asherflynt/voice-clock/docs/renders.md

# Renders

All images are rendered in Blender (Cycles) from the parametric CAD in `cad/` and the same paint data the slicer gets. Wood tones are shown as their filament or blended colour, so real prints will differ slightly.

## Turned walnut, Full Spectrum (8 tones)

Print files: [`print/wood_walnut`](../print/wood_walnut/README.md)

| | |
|---|---|
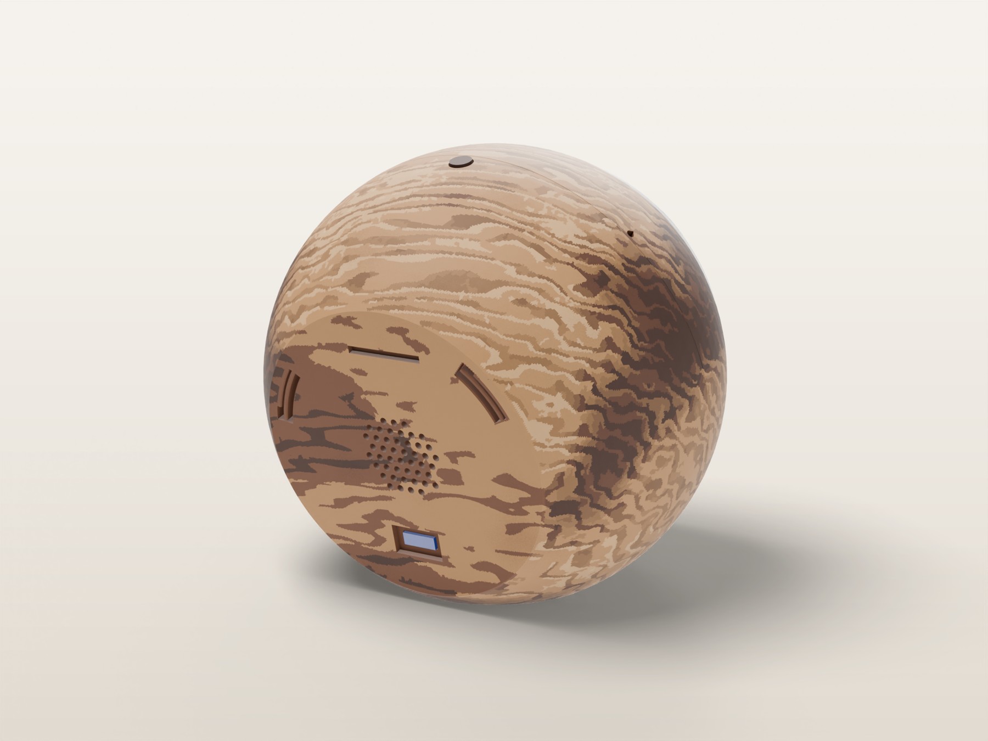
[picture p6: docs/img/wood/walnut_back.jpg]
back
| front |  |
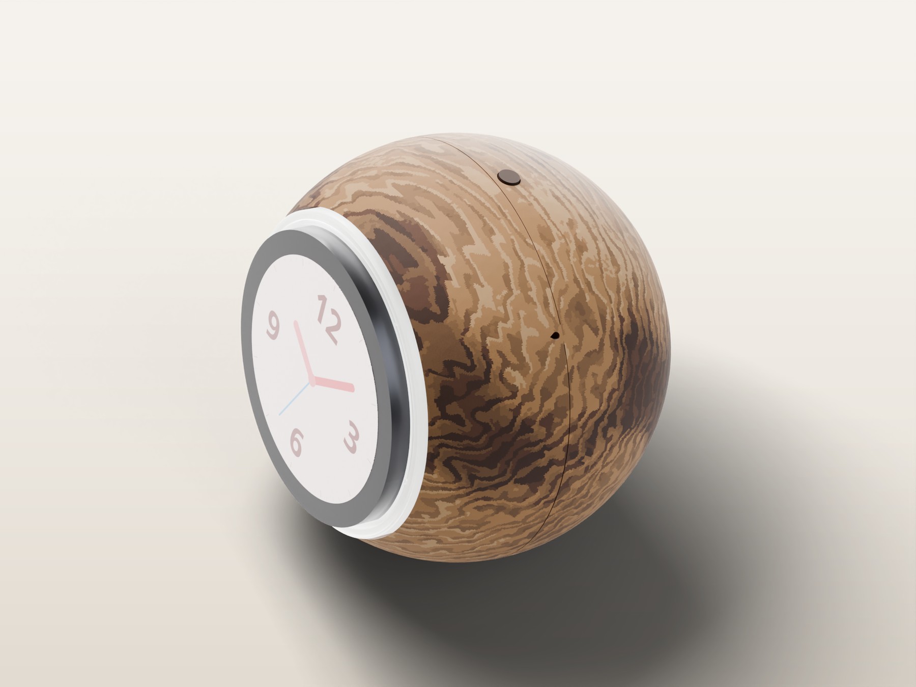
[picture p7: docs/img/wood/walnut_top.jpg]
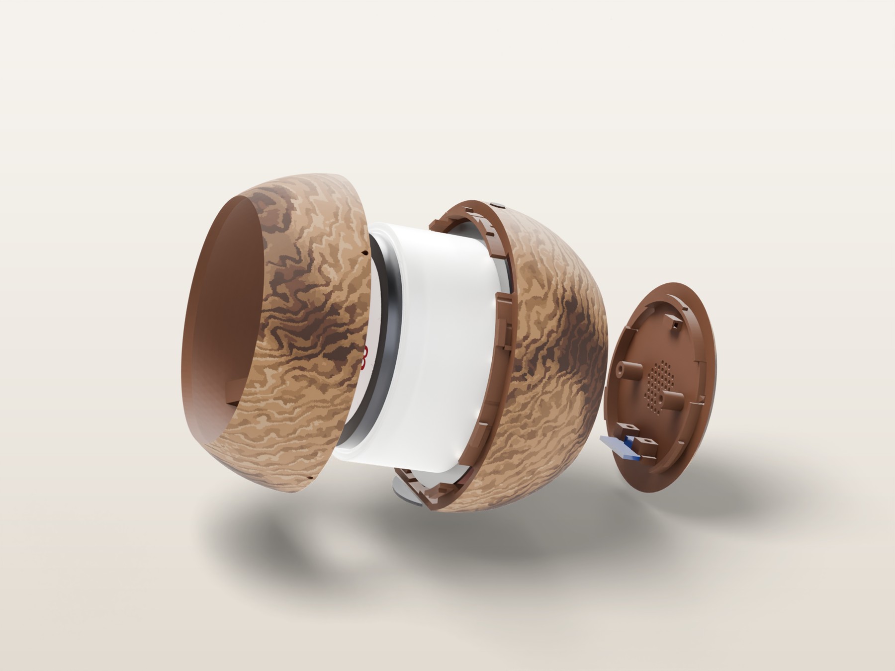
[picture p8: docs/img/wood/walnut_parts.jpg]
|  |  |

## Turned cherry

Print files: [`print/wood`](../print/wood/README.md)

| | |
|---|---|
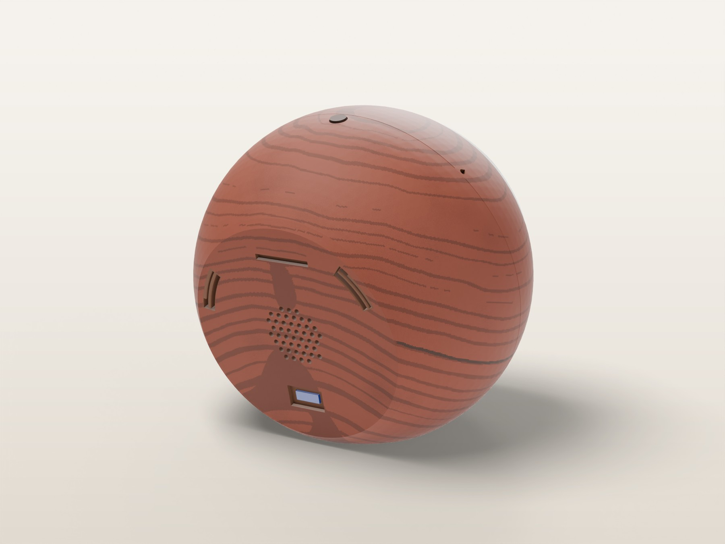
[picture p9: docs/img/wood/wood_back.jpg]
back
| front |  |
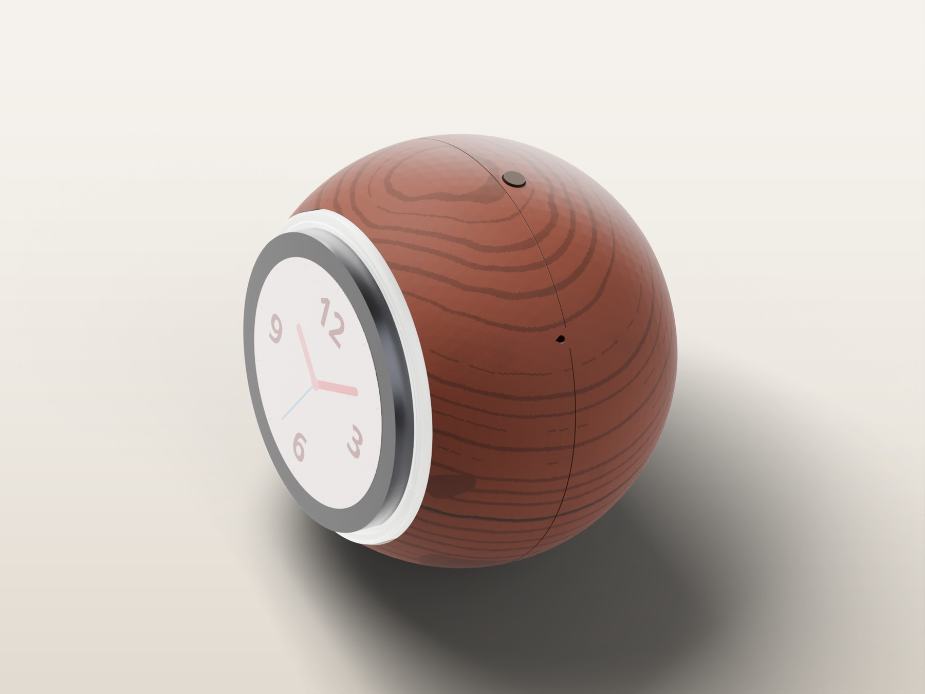
[picture p10: docs/img/wood/wood_top.jpg]
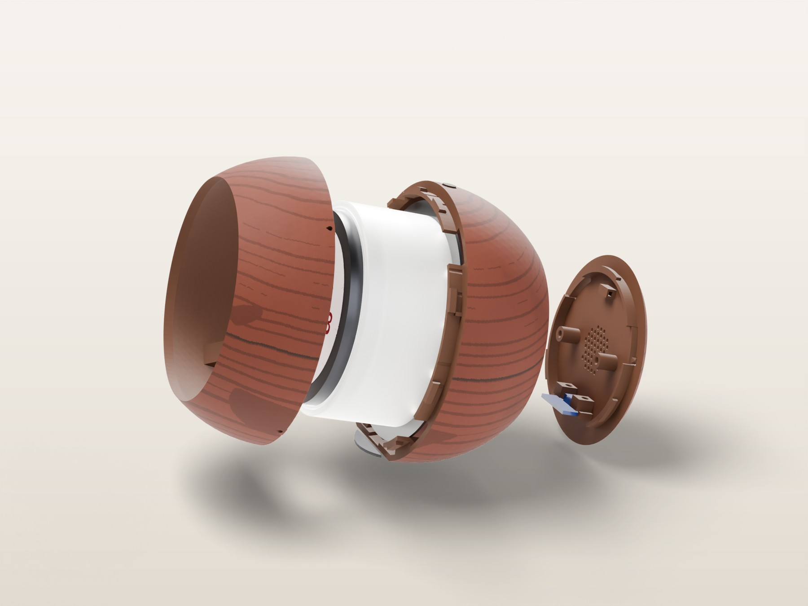
[picture p11: docs/img/wood/wood_parts.jpg]
|  |  |

## Standard build and assembly steps

In order, as used in the [assembly guide](assembly/ASSEMBLY.md).

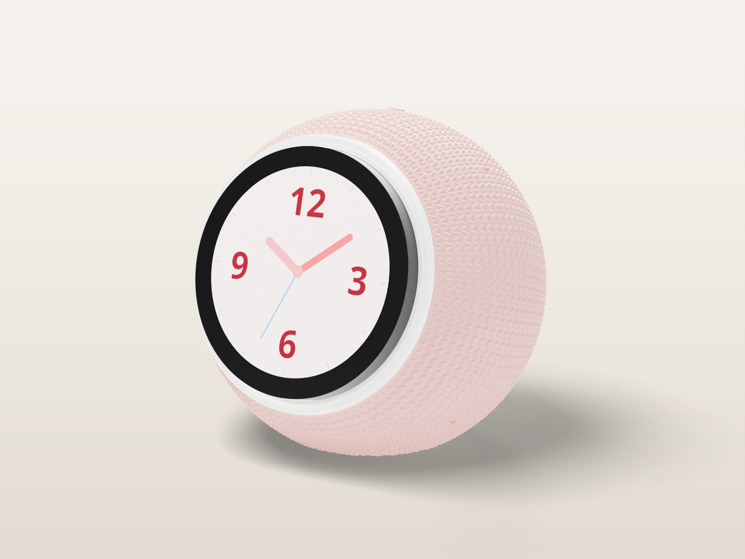
[picture p12: docs/assembly/img/hero_front.jpg]
hero_front


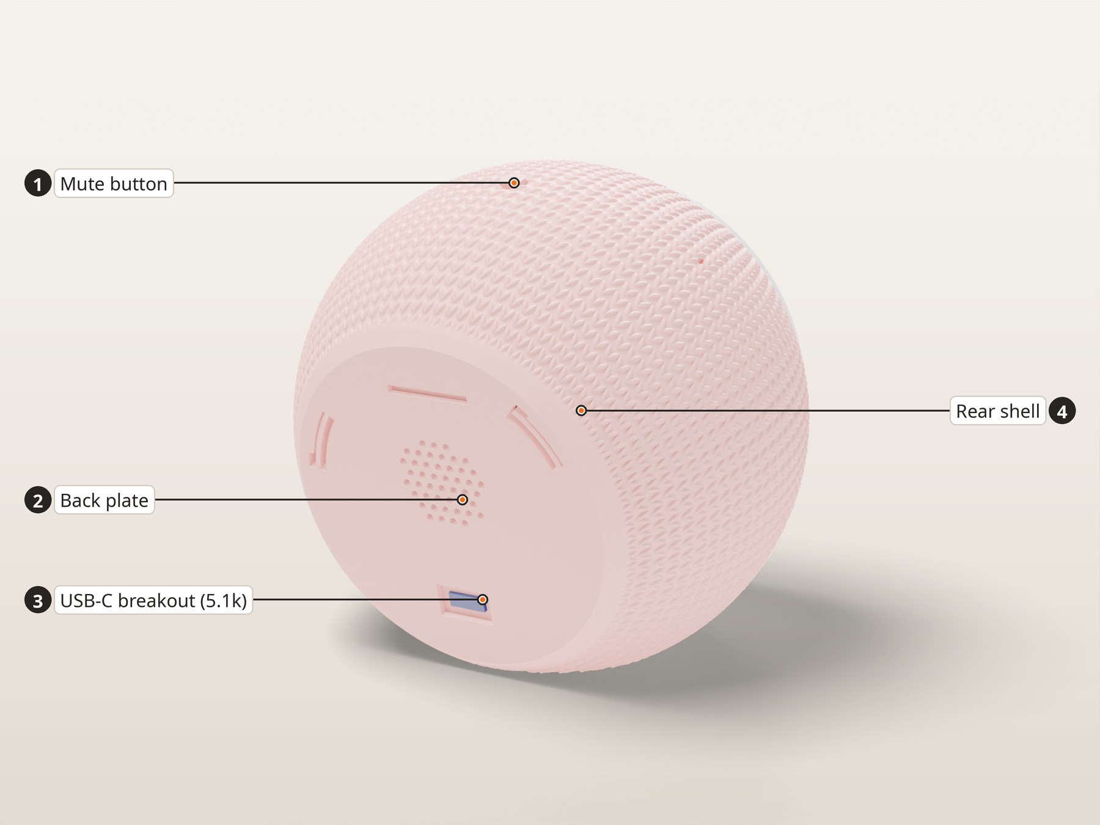
[picture p13: docs/assembly/img/hero_back.jpg]
hero_back


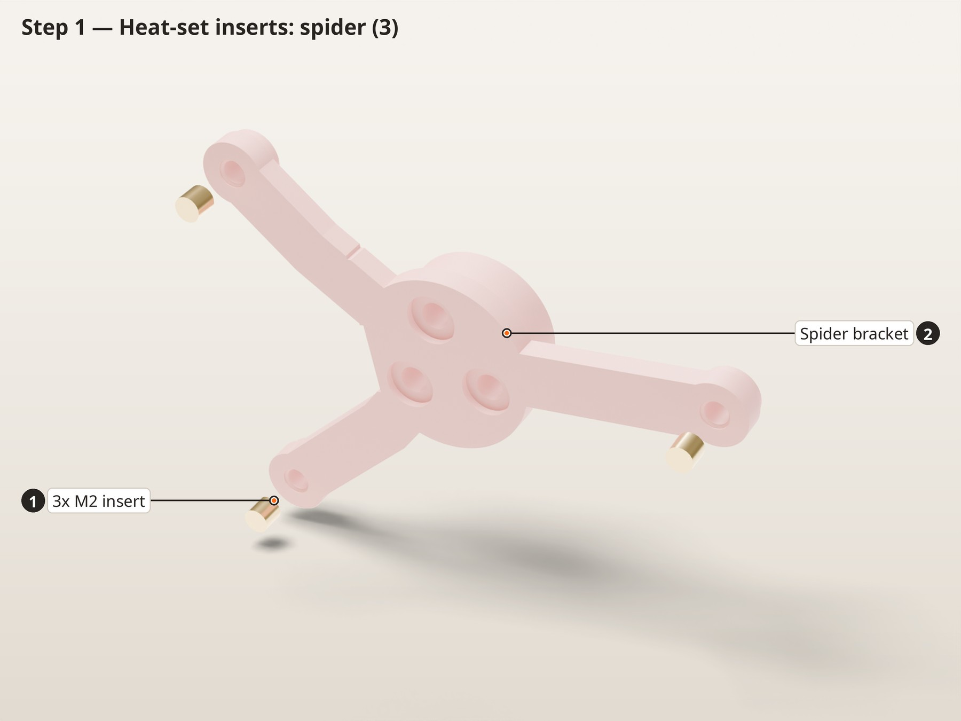
[picture p14: docs/assembly/img/step_01.jpg]
step_01


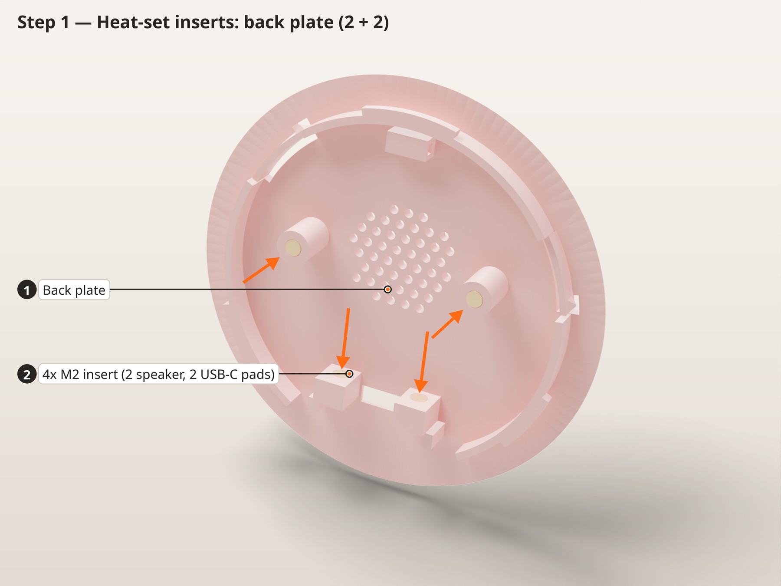
[picture p15: docs/assembly/img/step_01b.jpg]
step_01b


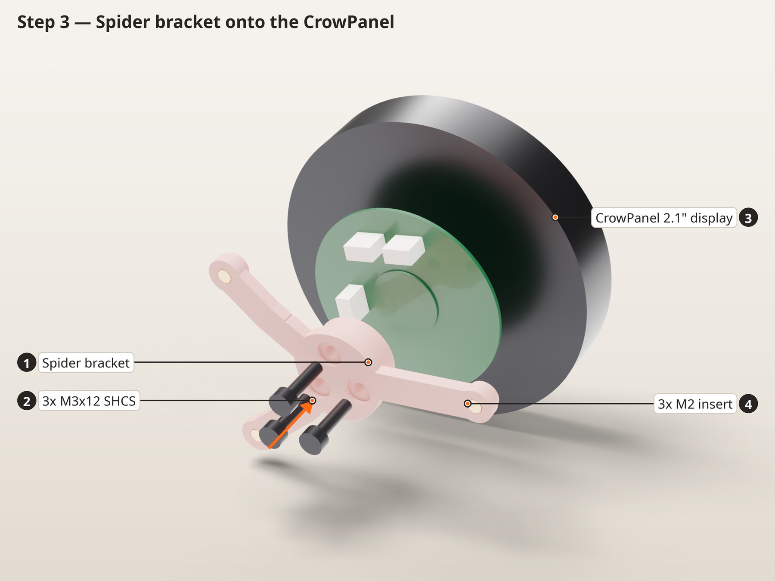
[picture p16: docs/assembly/img/step_02.jpg]
step_02


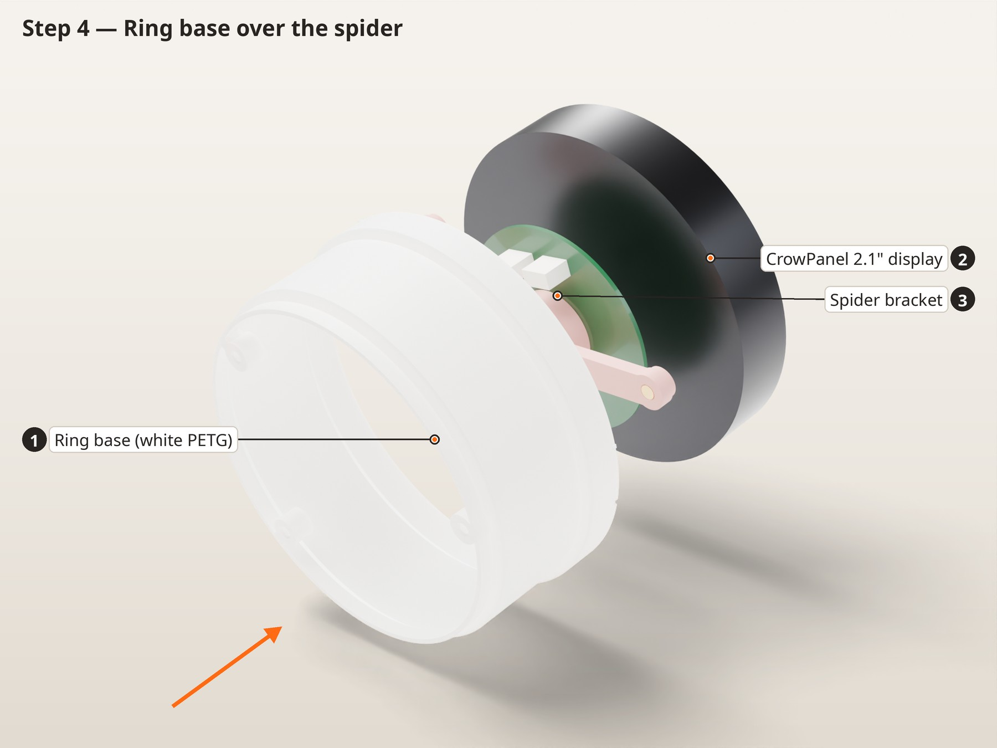
[picture p17: docs/assembly/img/step_03.jpg]
step_03


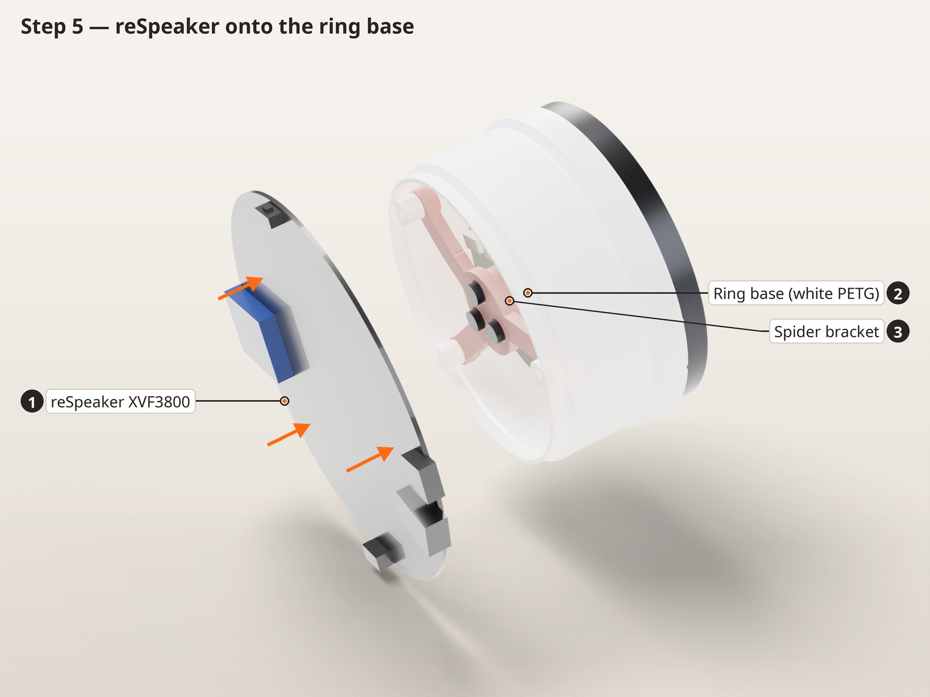
[picture p18: docs/assembly/img/step_04.jpg]
step_04


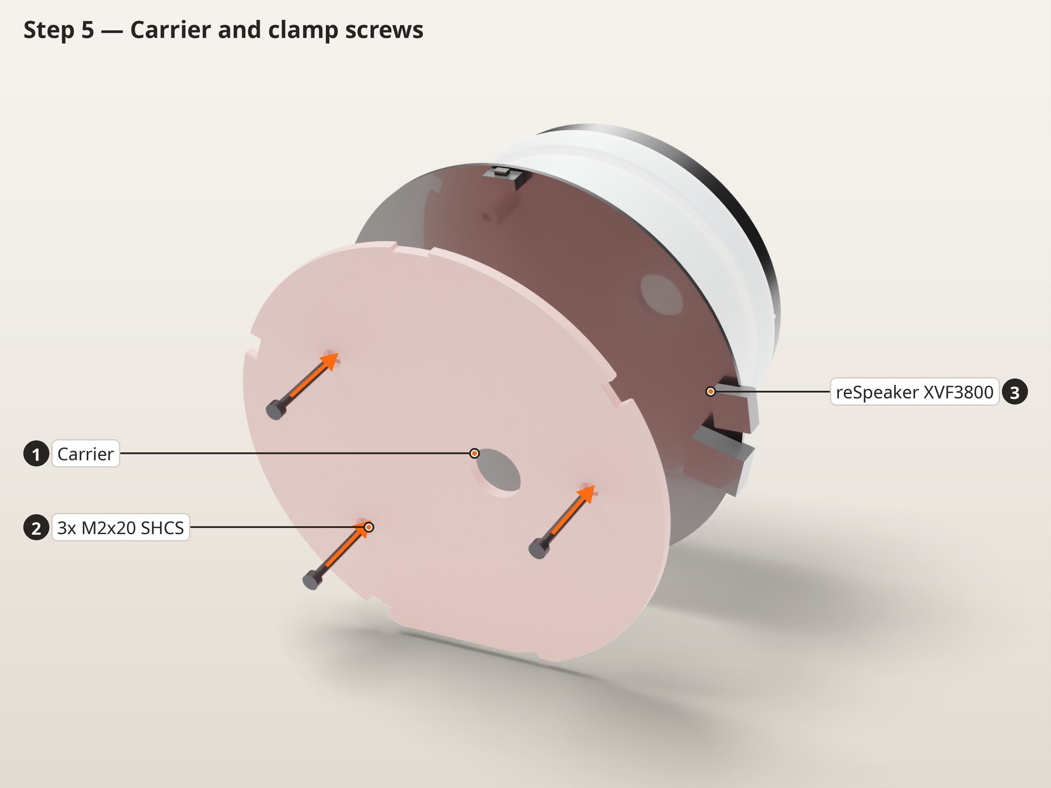
[picture p19: docs/assembly/img/step_05.jpg]
step_05


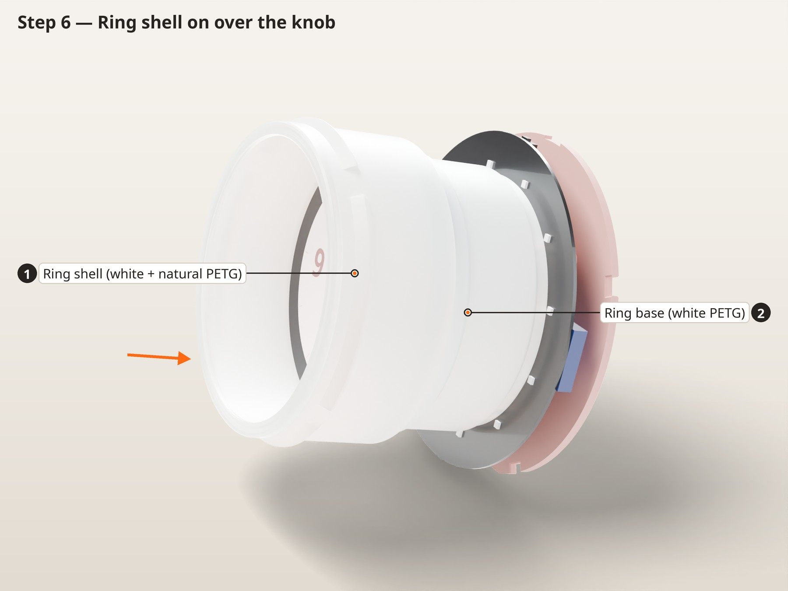
[picture p20: docs/assembly/img/step_06.jpg]
step_06


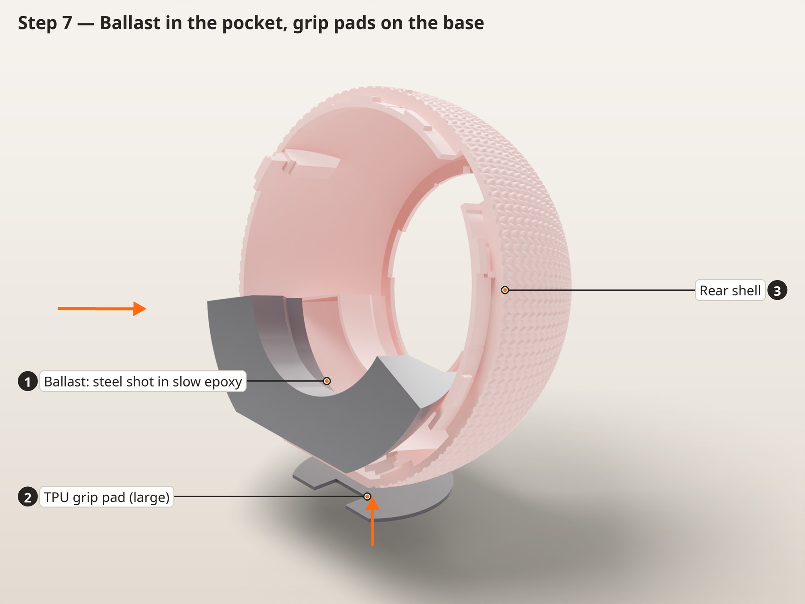
[picture p21: docs/assembly/img/step_07.jpg]
step_07


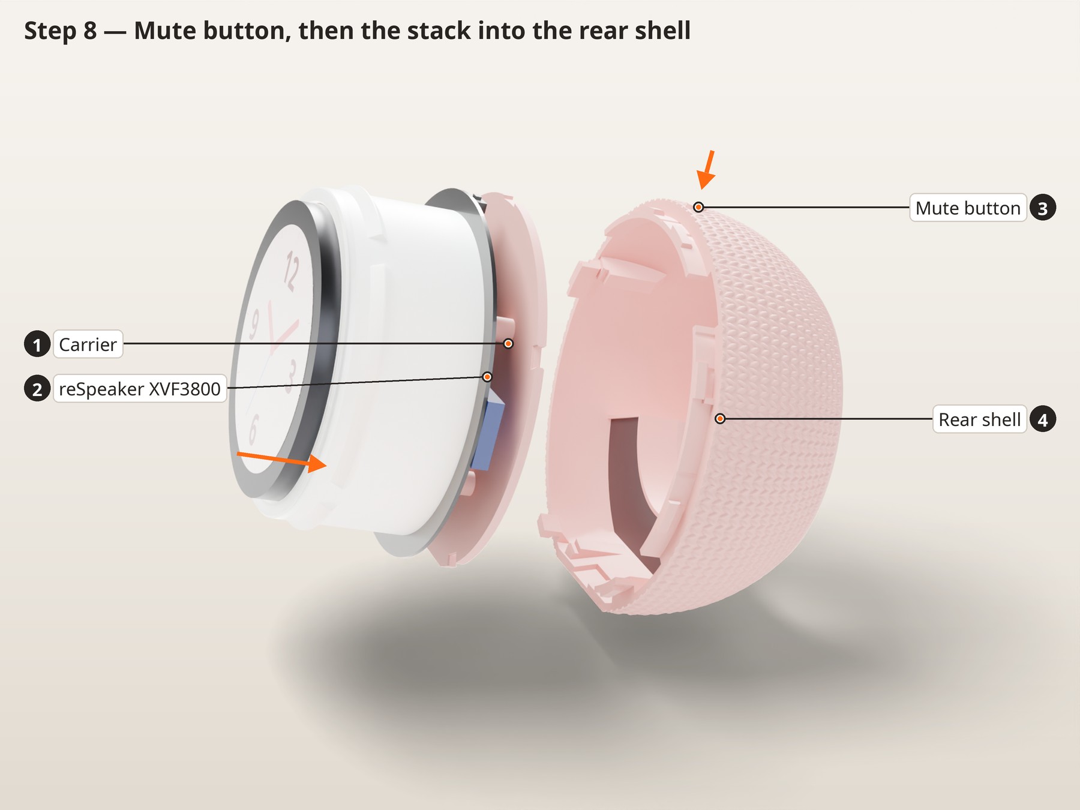
[picture p22: docs/assembly/img/step_08.jpg]
step_08


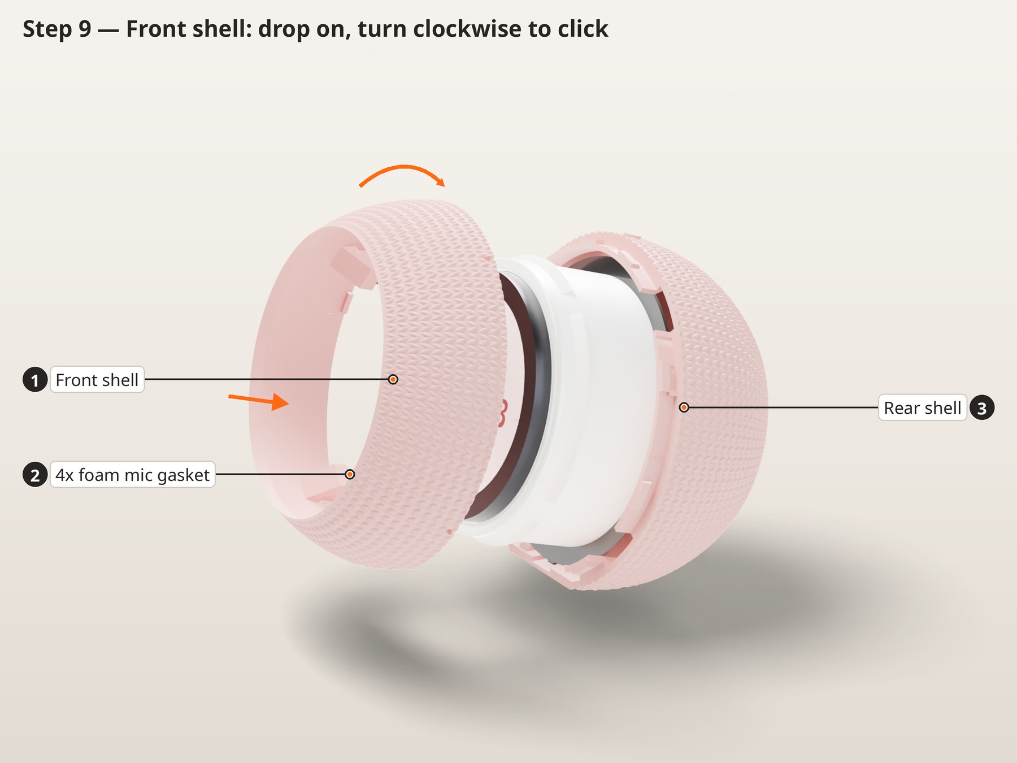
[picture p23: docs/assembly/img/step_09.jpg]
step_09


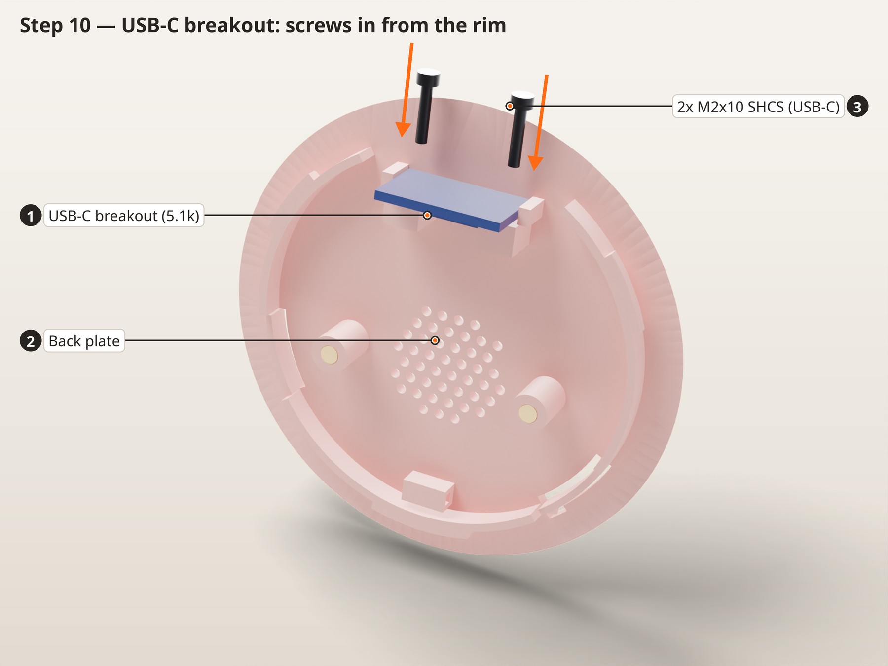
[picture p24: docs/assembly/img/step_10.jpg]
step_10


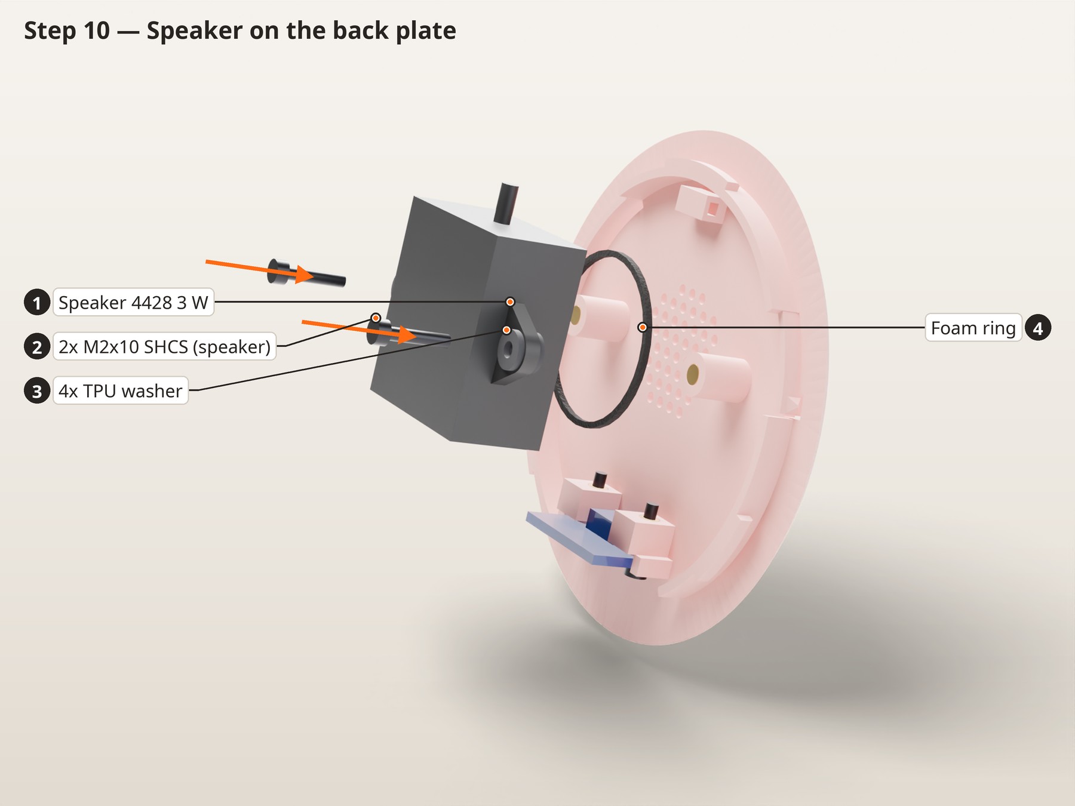
[picture p25: docs/assembly/img/step_10b.jpg]
step_10b


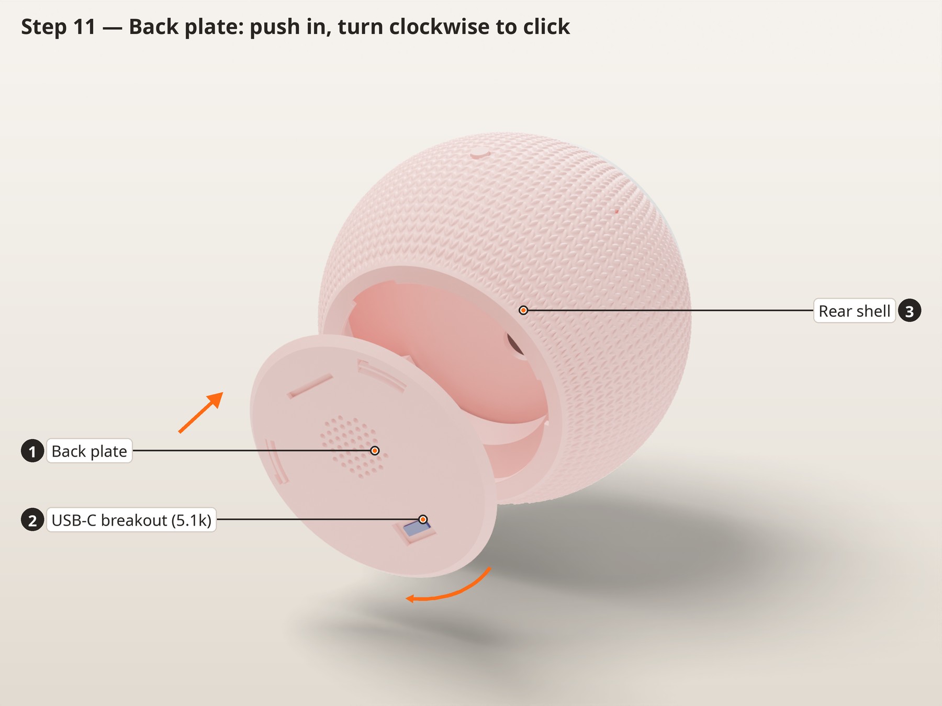
[picture p26: docs/assembly/img/step_11.jpg]
step_11


## Side section

Side section
