asherflynt/voice-clock/cad/blender/clockface.png

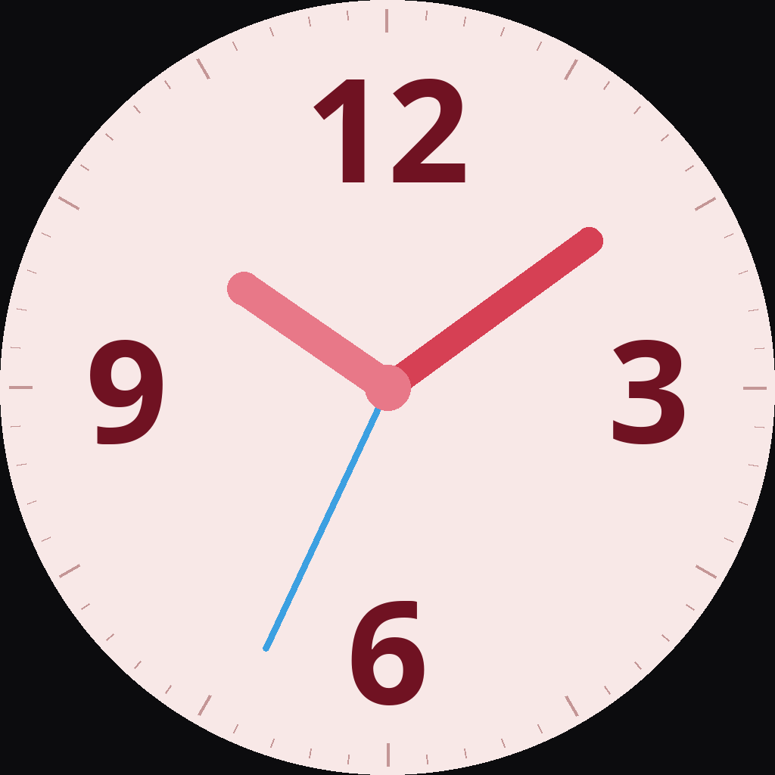
cad/blender/clockface.png
