asherflynt/voice-clock/print/step/assembly_D.step

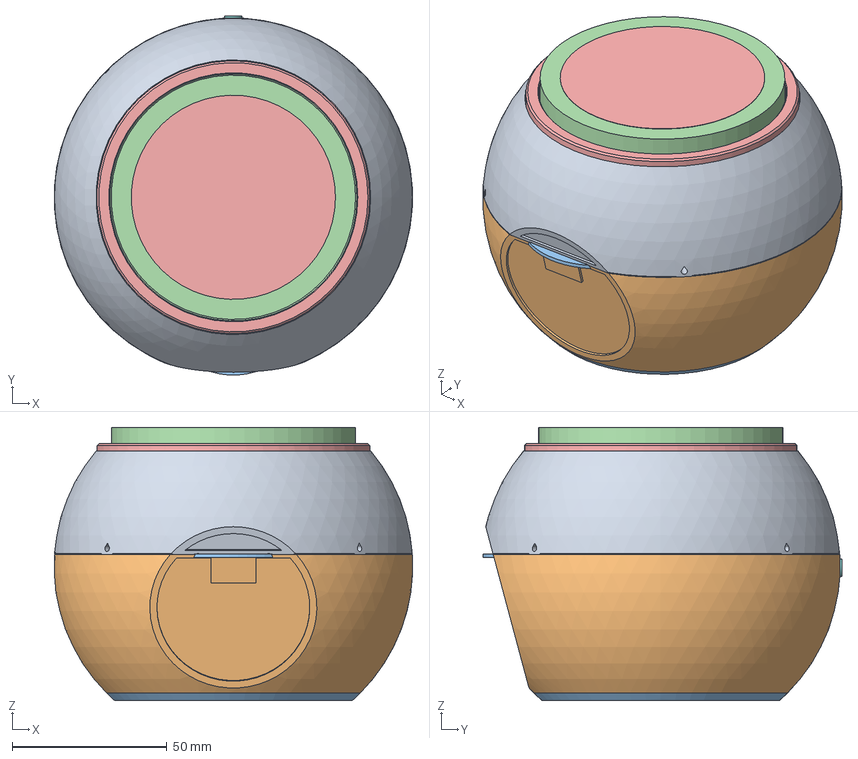
[picture p28: CAD file, 2026-11-12]
print/step/assembly_D.step
115.8 x 116.1 x 88.3 mm
Open_CASCADE_STEP_translator_7_9_1
