asherflynt/voice-clock/print/bambu/VoiceClock_P1S.3mf

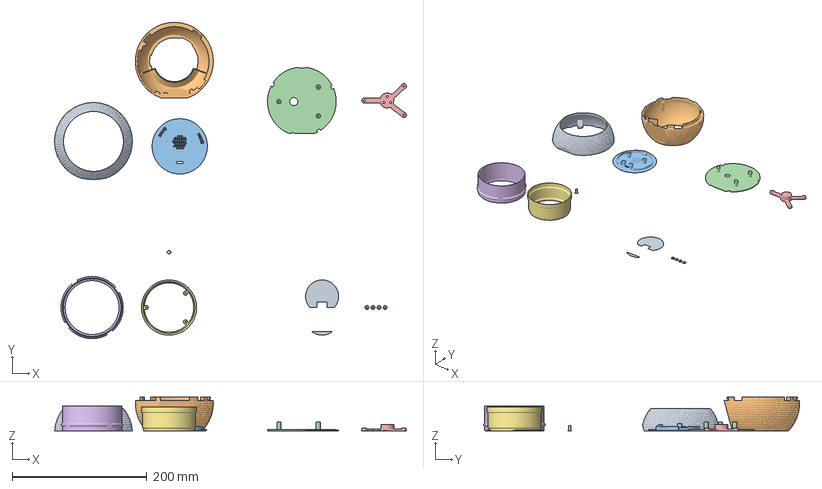
[picture p29: CAD file, 2026-11-12]
print/bambu/VoiceClock_P1S.3mf
522.3 x 469.5 x 50.4 mm
front_shell
rear_shell
back_plate
carrier
spider
ring_shell_2c
ring_base
mute_plunger
foot_pads
tpu_washers
