asherflynt/voice-clock/print/fit_tests/VoiceClock_v2_fit_plate2.3mf

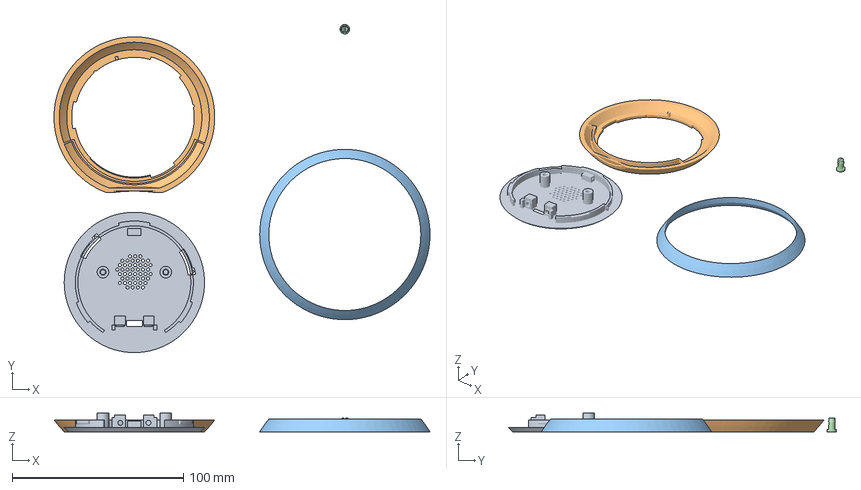
[picture p30: CAD file, 2026-11-10]
print/fit_tests/VoiceClock_v2_fit_plate2.3mf
219.7 x 191.8 x 10.9 mm
back_plate
fit_back_ring
fit_front_top
mute_plunger
