asherflynt/voice-clock/print/light_ring/LightRing_PETG_U1.3mf

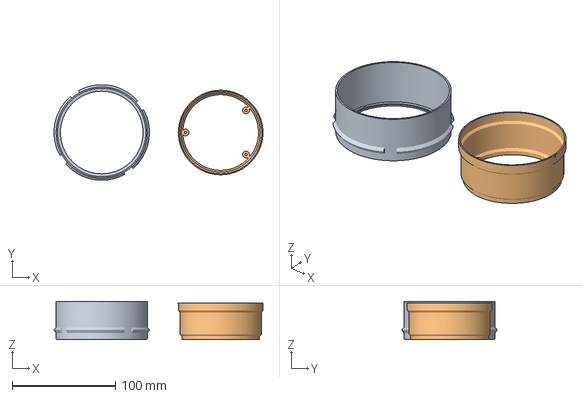
[picture p31: CAD file, 2026-11-11]
print/light_ring/LightRing_PETG_U1.3mf
202.3 x 92.4 x 36.9 mm
ring_shell_2c
ring_base
