asherflynt/voice-clock/print/plates/VoiceClock_plate1.3mf

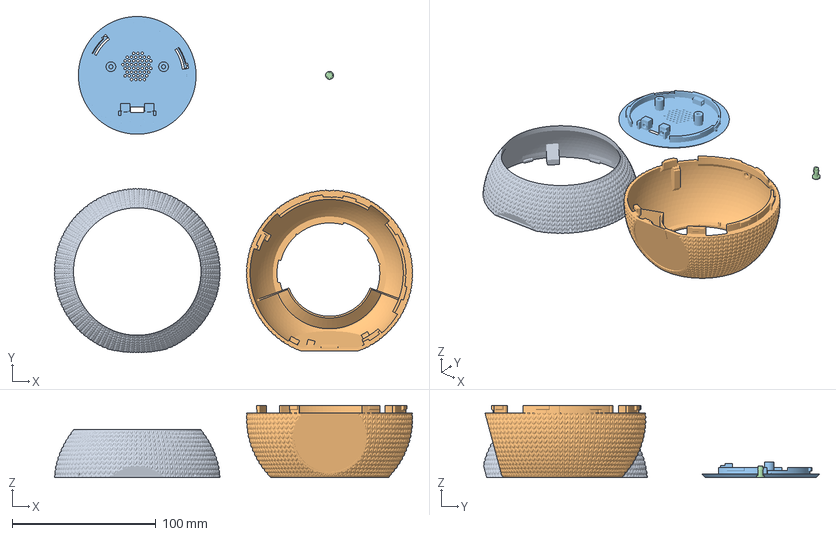
[picture p32: CAD file, 2026-11-12]
print/plates/VoiceClock_plate1.3mf
249.8 x 234.1 x 50.4 mm
front_shell
rear_shell
back_plate
mute_plunger
