asherflynt/voice-clock/print/step/spider.step

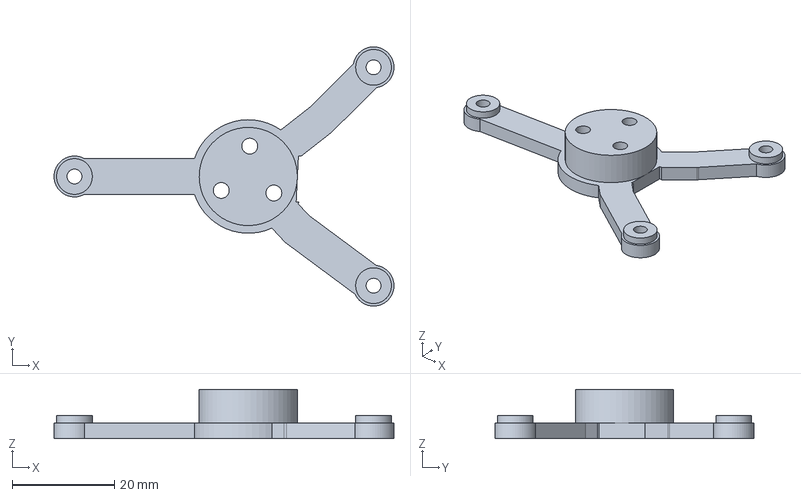
[picture p33: CAD file, 2026-11-12]
print/step/spider.step
66.5 x 50.7 x 9.60 mm
