asherflynt/voice-clock/print/stl/ring_shell_natural.stl

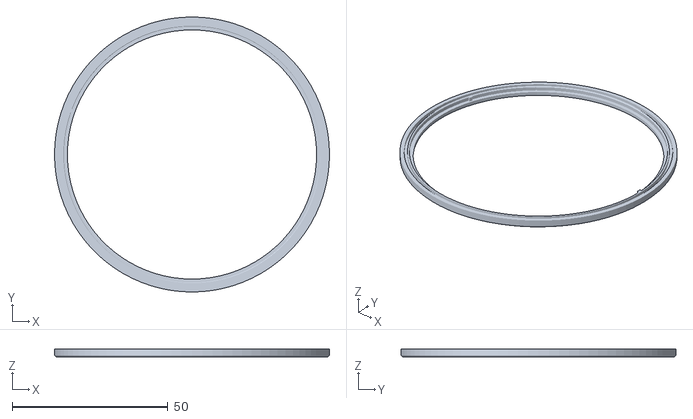
[picture p34: CAD file, 2026-11-11]
print/stl/ring_shell_natural.stl
88.2 x 88.2 x 2.65
