asherflynt/voice-clock/print/tpu/TPU_U1.3mf

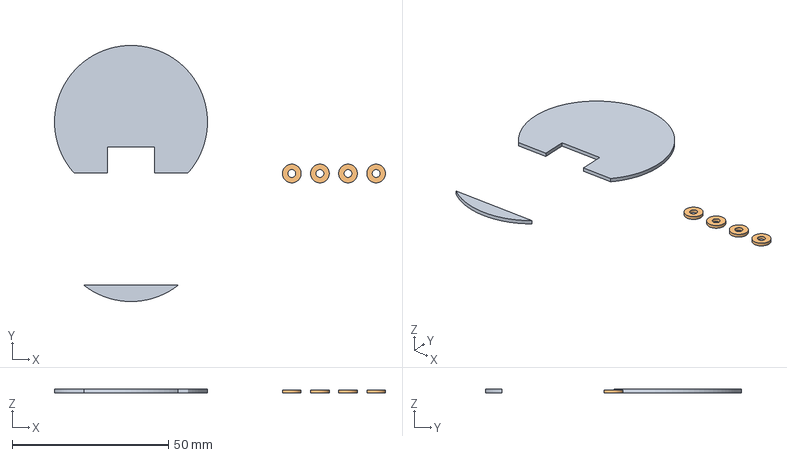
[picture p35: CAD file, 2026-11-12]
print/tpu/TPU_U1.3mf
106.0 x 82.0 x 1.20 mm
foot_pads
tpu_washers
