asherflynt/voice-clock/print/v3_light_sensor/VoiceClock_walnut_fs_008_U1_light_sensor.3mf

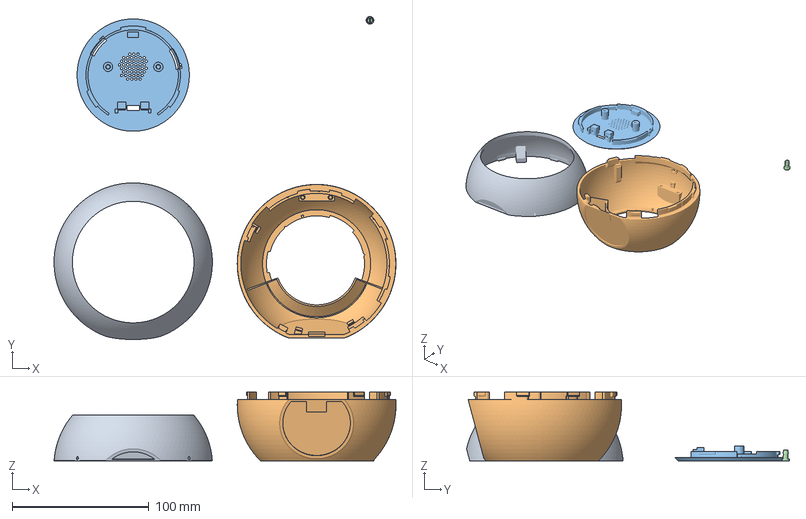
[picture p36: CAD file, 2026-11-13]
print/v3_light_sensor/VoiceClock_walnut_fs_008_U1_light_sensor.3mf
249.8 x 236.0 x 50.4 mm
front_shell
rear_shell
back_plate
mute_plunger
