asherflynt/voice-clock/print/VoiceClock_U1.3mf

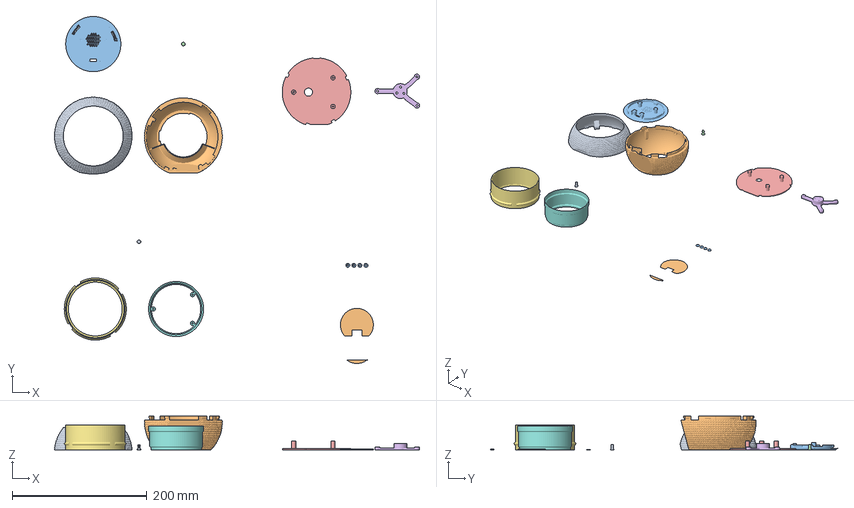
[picture p37: CAD file, 2026-11-12]
print/VoiceClock_U1.3mf
543.1 x 516.0 x 50.4 mm
front_shell
rear_shell
back_plate
mute_plunger x 2
carrier
spider
ring_shell_2c
ring_base
foot_pads
tpu_washers
