asherflynt/voice-clock/print/wood/coupons/C1_JAYO_Wood_Cherry_U1.3mf

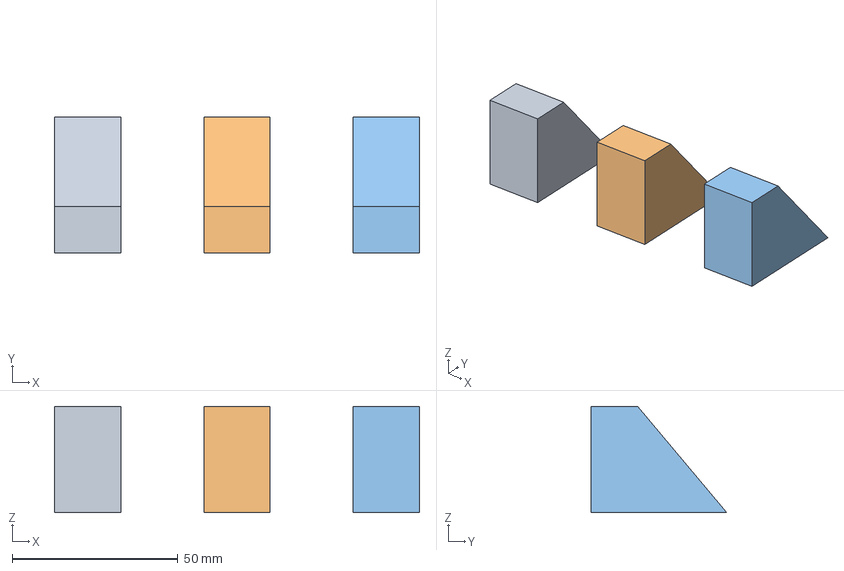
[picture p38: CAD file, 2026-11-07]
print/wood/coupons/C1_JAYO_Wood_Cherry_U1.3mf
110.0 x 40.9 x 32.0 mm
c1_2p5
c1_4
c1_8
