asherflynt/voice-clock/print/wood/VoiceClock_wood_U1.3mf

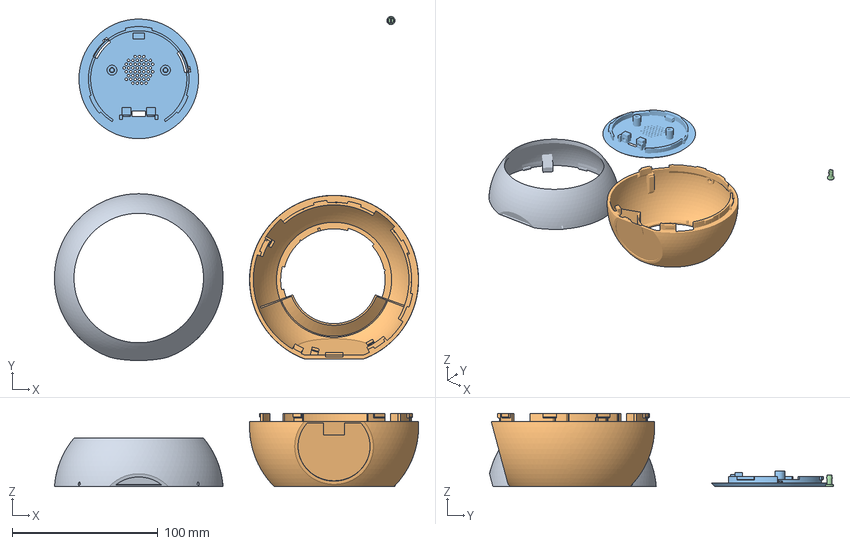
[picture p39: CAD file, 2026-11-10]
print/wood/VoiceClock_wood_U1.3mf
249.8 x 236.0 x 50.4 mm
front_shell
rear_shell
back_plate
mute_plunger
