asherflynt/voice-clock/print/wood_walnut/coupons/FS_swatch_008.3mf

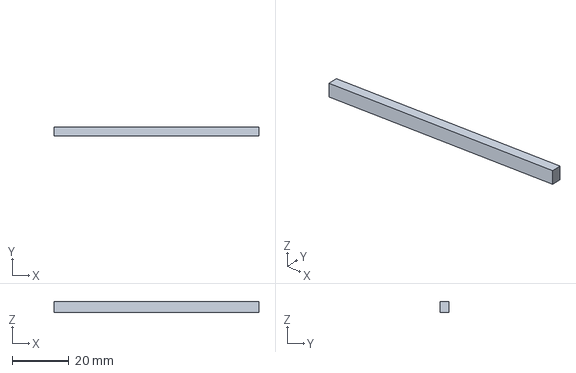
[picture p40: CAD file, 2026-11-07]
print/wood_walnut/coupons/FS_swatch_008.3mf
72.0 x 3.00 x 4.00 mm
