asherflynt/voice-clock/print/bambu/VoiceClock_A1mini.3mf

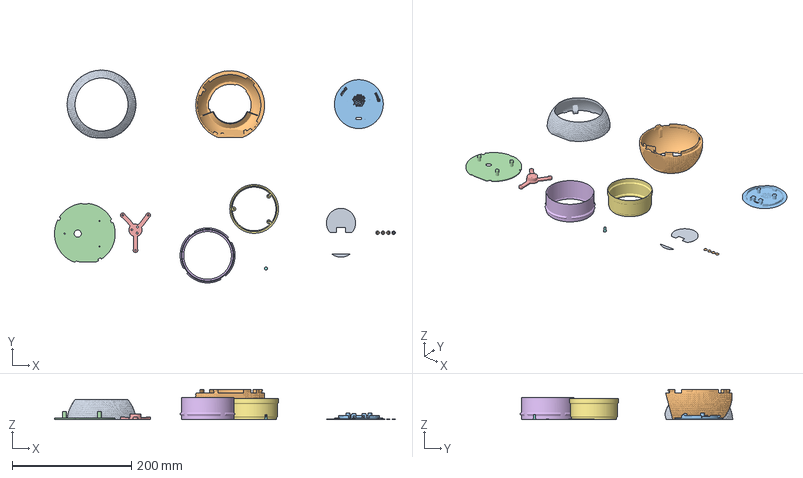
[picture p41: CAD file, 2026-11-12]
print/bambu/VoiceClock_A1mini.3mf
572.5 x 357.3 x 50.4 mm
front_shell
rear_shell
back_plate
carrier
spider
ring_shell_2c
ring_base
mute_plunger
foot_pads
tpu_washers
