asherflynt/voice-clock/print/fit_tests/VoiceClock_v2_fit_tests.3mf

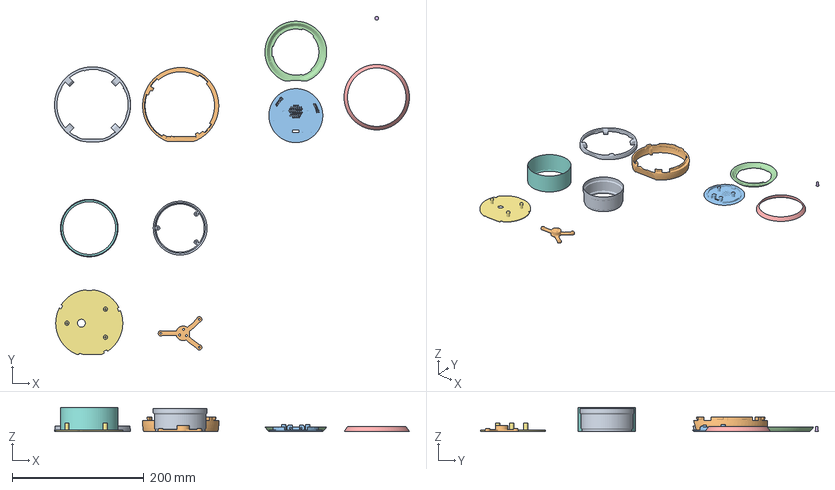
[picture p42: CAD file, 2026-11-10]
print/fit_tests/VoiceClock_v2_fit_tests.3mf
539.6 x 514.1 x 36.9 mm
fit_front_band
fit_rear_band
back_plate
fit_back_ring
fit_front_top
mute_plunger
carrier
ring_shell
ring_base
spider
