asherflynt/voice-clock/print/light_ring/LightRingShell_PETG_model.3mf

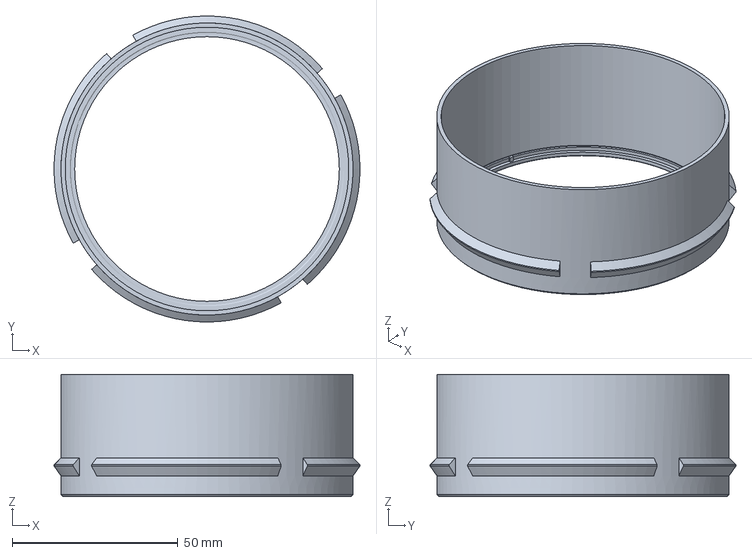
[picture p43: CAD file, 2026-11-11]
print/light_ring/LightRingShell_PETG_model.3mf
92.4 x 92.4 x 36.9 mm
