asherflynt/voice-clock/print/plates/VoiceClock_light_ring_PETG.3mf

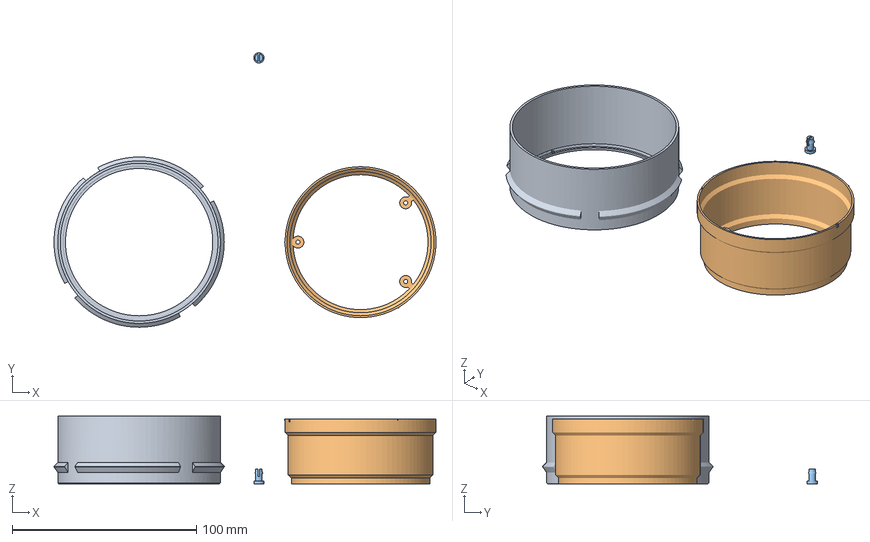
[picture p44: CAD file, 2026-11-12]
print/plates/VoiceClock_light_ring_PETG.3mf
207.3 x 149.0 x 36.9 mm
ring_shell_2c
ring_base
mute_plunger
