asherflynt/voice-clock/print/stl/ring_shell_white.stl

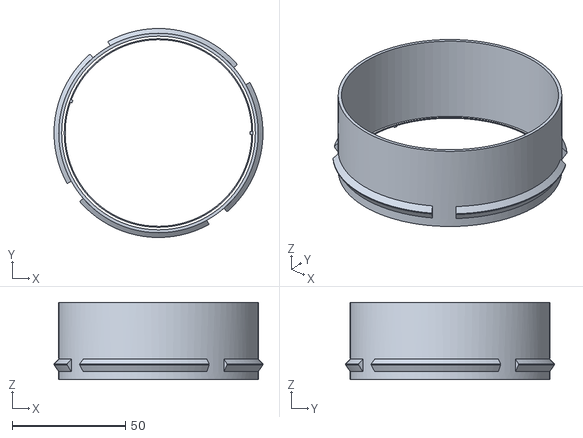
[picture p45: CAD file, 2026-11-11]
print/stl/ring_shell_white.stl
92.4 x 92.4 x 34.2
