asherflynt/voice-clock/print/fit_tests/VoiceClock_v2_fit_plate3.3mf

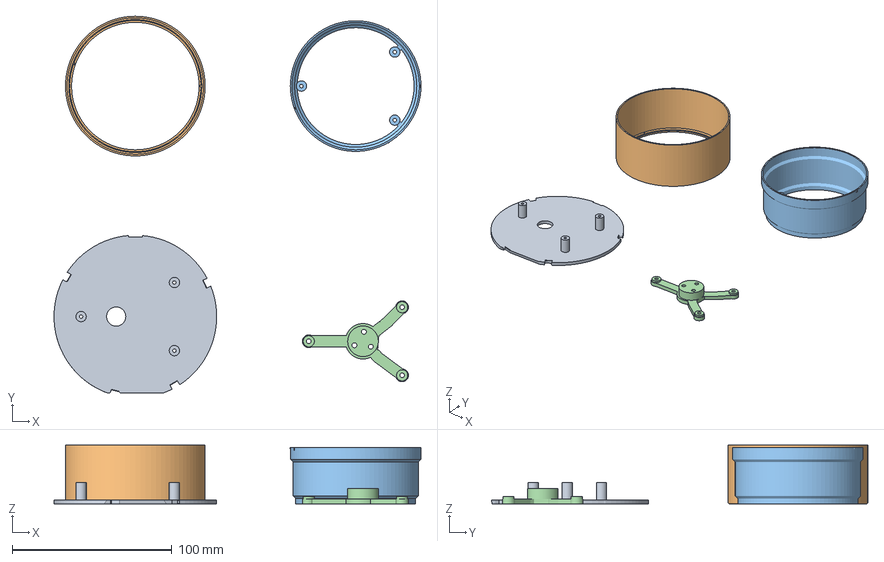
[picture p46: CAD file, 2026-11-10]
print/fit_tests/VoiceClock_v2_fit_plate3.3mf
230.1 x 236.1 x 36.9 mm
carrier
ring_shell
ring_base
spider
