asherflynt/voice-clock/print/plates/VoiceClock_back_plate_only_generic.3mf

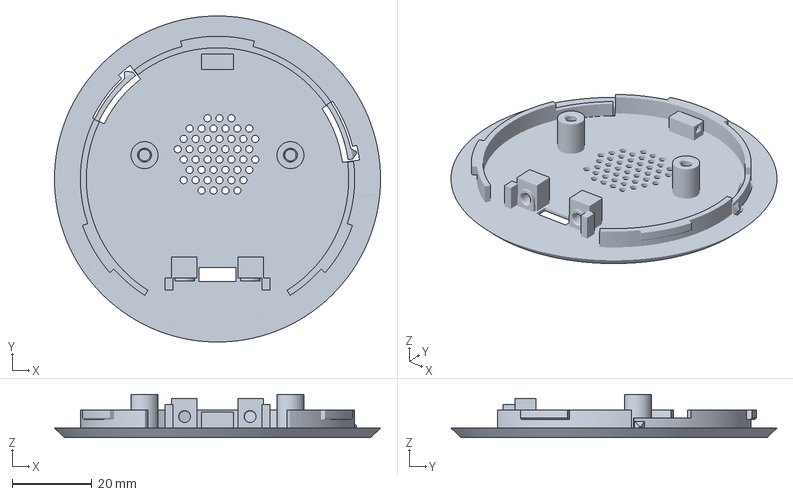
[picture p47: CAD file, 2026-11-12]
print/plates/VoiceClock_back_plate_only_generic.3mf
82.0 x 82.0 x 10.9 mm
