asherflynt/voice-clock/print/step/ring_shell.step

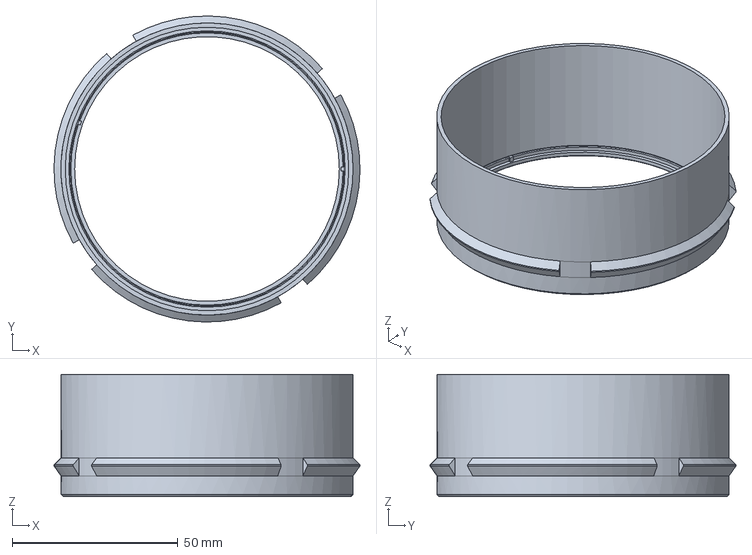
[picture p48: CAD file, 2026-11-11]
print/step/ring_shell.step
92.4 x 92.4 x 36.9 mm
