asherflynt/voice-clock/print/fit_tests/VoiceClock_v2_fit_plate1.3mf

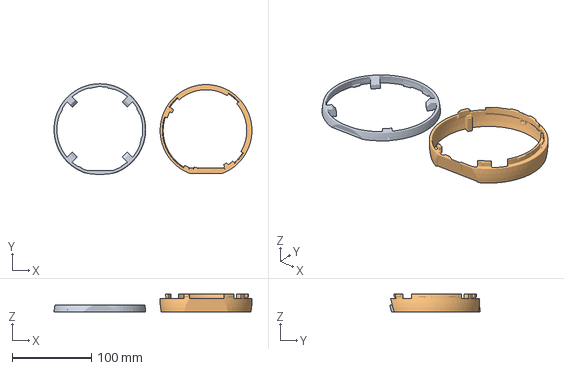
[picture p49: CAD file, 2026-11-09]
print/fit_tests/VoiceClock_v2_fit_plate1.3mf
249.8 x 114.3 x 22.1 mm
fit_front_band
fit_rear_band
