asherflynt/voice-clock/print/v3_light_sensor/carrier_light_sensor.step

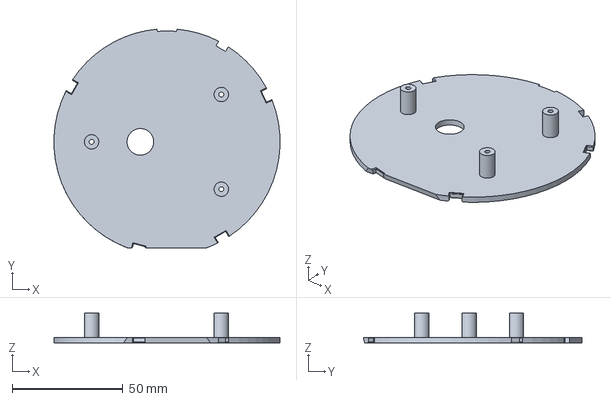
[picture p50: CAD file, 2026-11-13]
print/v3_light_sensor/carrier_light_sensor.step
101.9 x 98.6 x 13.4 mm
