asherflynt/voice-clock/print/plates/VoiceClock_internals_with_back_plate_PLA.3mf

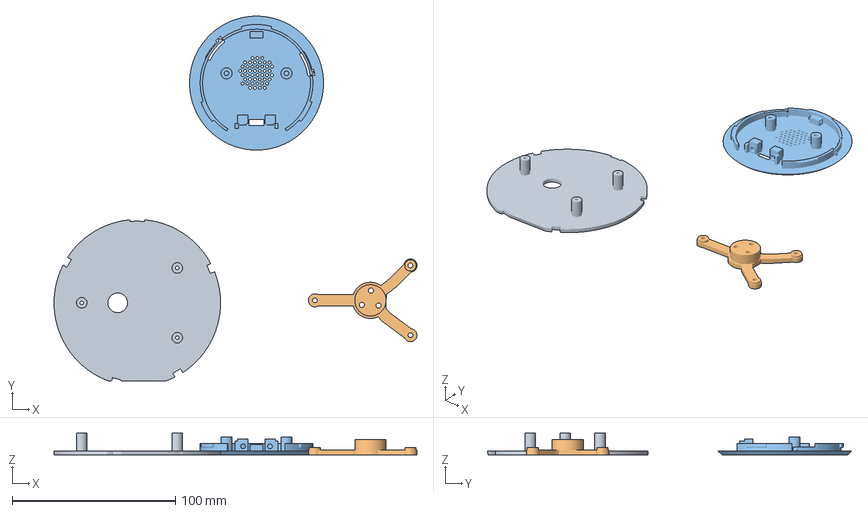
[picture p51: CAD file, 2026-11-12]
print/plates/VoiceClock_internals_with_back_plate_PLA.3mf
222.2 x 223.3 x 13.4 mm
carrier
spider
back_plate
