asherflynt/voice-clock/print/step/ring_base.step

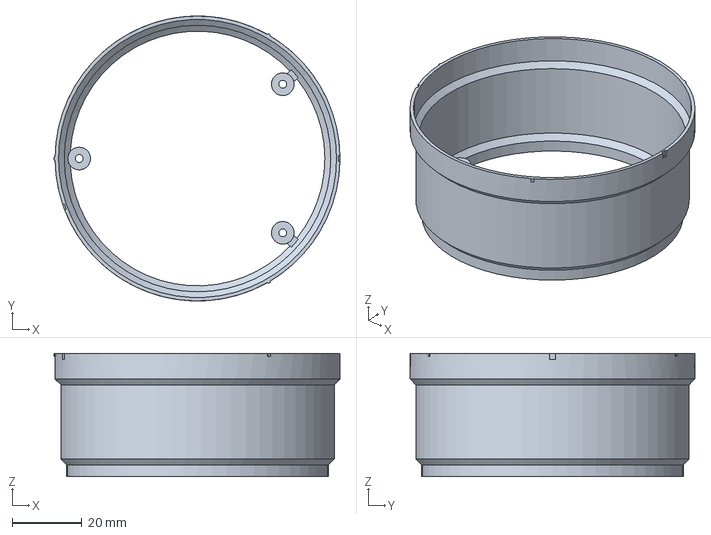
[picture p52: CAD file, 2026-11-10]
print/step/ring_base.step
82.2 x 81.9 x 35.4 mm
