asherflynt/voice-clock/print/v3_light_sensor/rear_shell_light_sensor.step

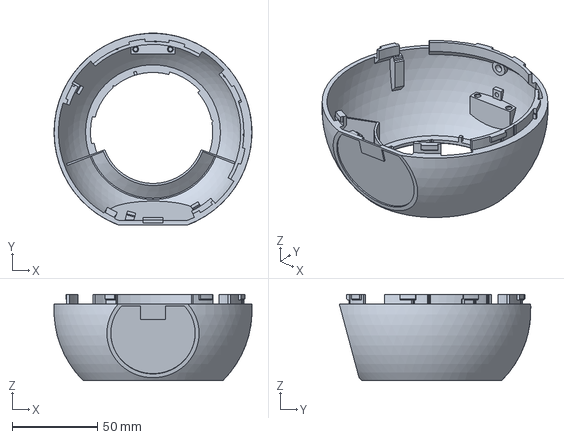
[picture p53: CAD file, 2026-11-13]
print/v3_light_sensor/rear_shell_light_sensor.step
115.9 x 112.1 x 50.4 mm
