asherflynt/voice-clock/print/plates/VoiceClock_plate2.3mf

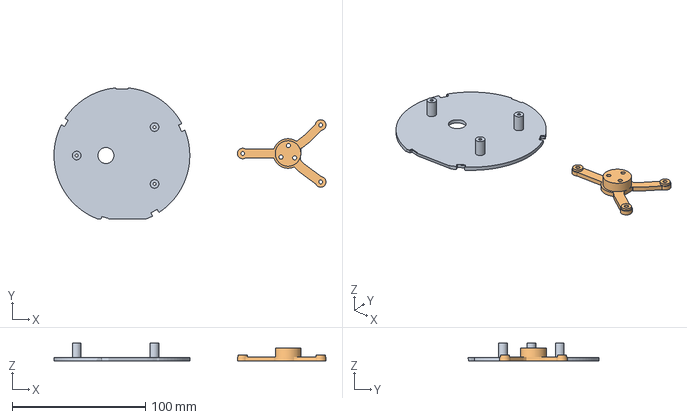
[picture p54: CAD file, 2026-11-12]
print/plates/VoiceClock_plate2.3mf
204.2 x 98.6 x 13.4 mm
carrier
spider
