asherflynt/voice-clock/print/plates/VoiceClock_shells_only_PLA_generic.3mf

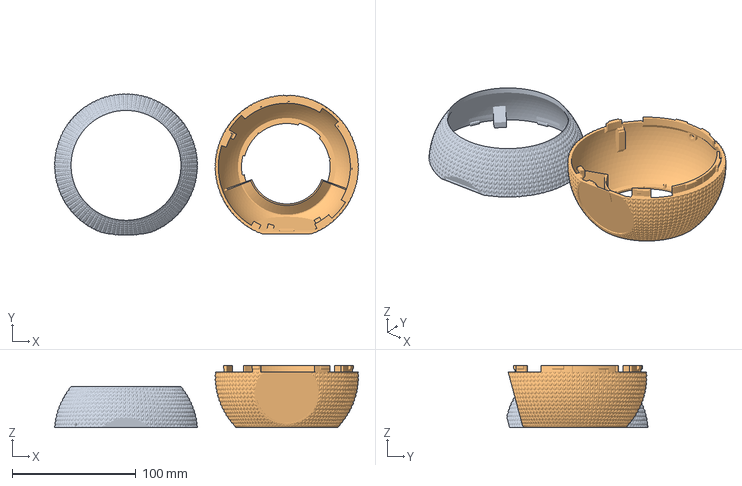
[picture p55: CAD file, 2026-11-12]
print/plates/VoiceClock_shells_only_PLA_generic.3mf
245.8 x 114.2 x 50.4 mm
front_shell
rear_shell
