asherflynt/voice-clock/print/plates/VoiceClock_plate4.3mf

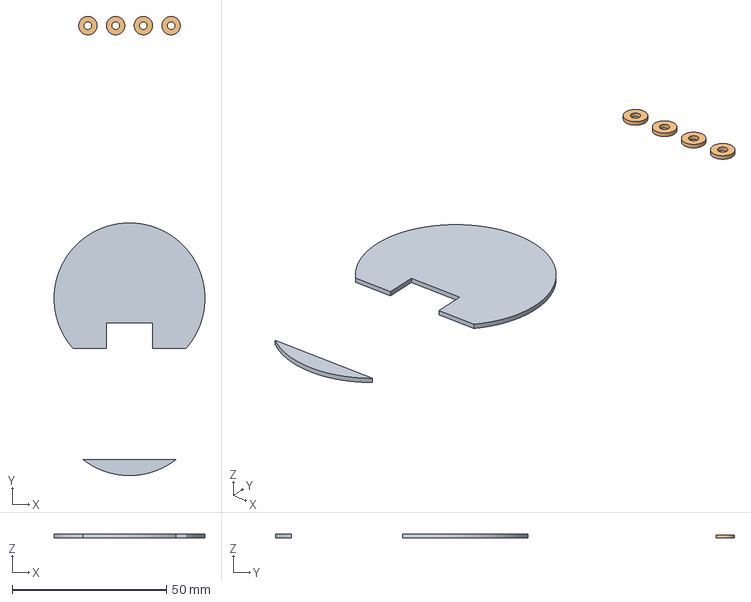
[picture p56: CAD file, 2026-11-12]
print/plates/VoiceClock_plate4.3mf
49.0 x 149.0 x 1.20 mm
foot_pads
tpu_washers
