asherflynt/voice-clock/print/step/mute_plunger.step

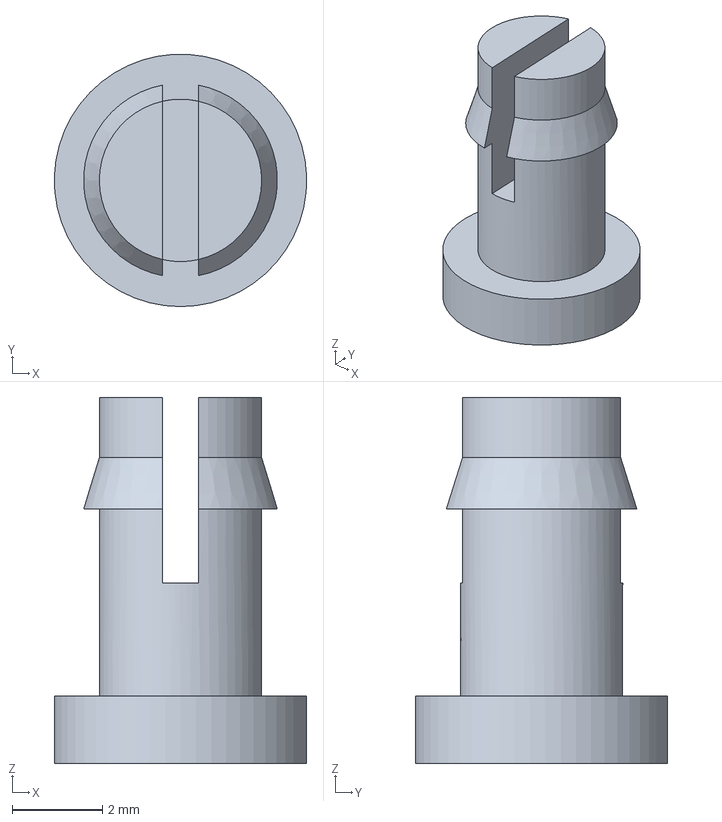
[picture p57: CAD file, 2026-11-07]
print/step/mute_plunger.step
5.60 x 5.59 x 8.12 mm
