asherflynt/voice-clock/print/step/foot_pads.step

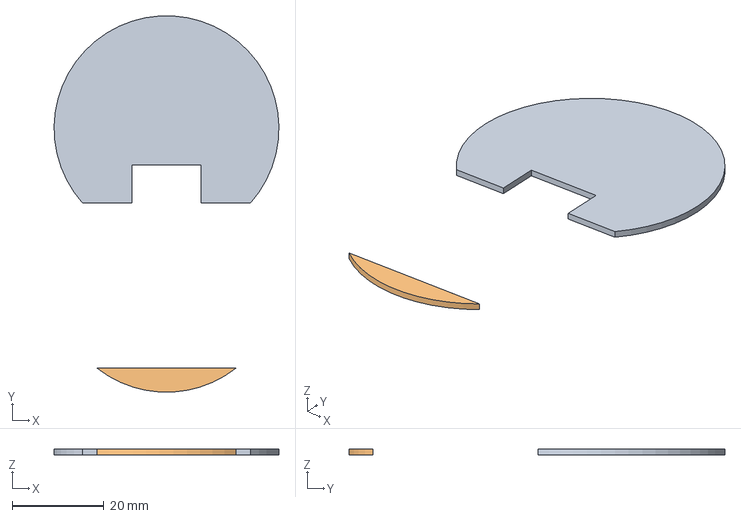
[picture p58: CAD file, 2026-11-07]
print/step/foot_pads.step
49.0 x 81.9 x 1.20 mm
