asherflynt/voice-clock/print/step/front_shell.step

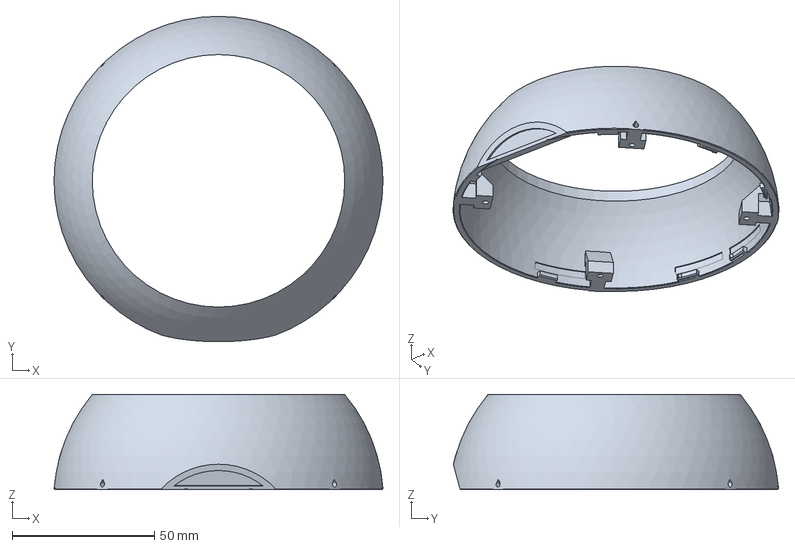
[picture p59: CAD file, 2026-11-07]
print/step/front_shell.step
115.7 x 114.4 x 33.4 mm
