asherflynt/voice-clock/(list of files, cad)

Other CAD files:
print/wood_walnut/VoiceClock_walnut_fs_008_U1.3mf
print/tpu/TPU_model.3mf
print/v3_light_sensor/VoiceClock_U1_light_sensor.3mf
print/wood/VoiceClock_wood_model.3mf
print/wood_walnut/VoiceClock_walnut_fs_model.3mf
print/bambu/VoiceClock_X1C.3mf
print/light_ring/LightRingShell_PETG_U1.3mf
print/v3_light_sensor/VoiceClock_wood_U1_light_sensor.3mf
print/bambu/VoiceClock_A1.3mf
print/light_ring/LightRing_PETG_model.3mf
print/plates/VoiceClock_externals_PLA_generic.3mf
print/step/back_plate.step
print/step/carrier.step
print/step/rear_shell.step
print/plates/VoiceClock_externals_PLA.3mf
print/plates/VoiceClock_back_plate_only.3mf
print/plates/VoiceClock_internals_PLA.3mf
print/plates/VoiceClock_plate3.3mf
print/plates/VoiceClock_internals_with_back_plate_PLA_generic.3mf
print/plates/VoiceClock_light_ring_PETG_generic.3mf
print/plates/VoiceClock_internals_PLA_generic.3mf
print/plates/VoiceClock_shells_only_PLA.3mf
print/step/tpu_washers.step
print/stl/back_plate.stl
print/stl/carrier.stl
print/stl/foot_pads.stl
print/stl/front_shell.stl
print/stl/mute_plunger.stl
print/stl/rear_shell.stl
print/stl/ring_base.stl
print/stl/ring_shell.stl
print/stl/spider.stl
print/stl/tpu_washers.stl
print/v3_light_sensor/carrier_light_sensor.stl
print/v3_light_sensor/rear_shell_light_sensor.stl
