asherflynt/voice-clock/docs/wiring/WIRING.md

# Voice Clock wiring and soldering

Apart from the optional v3 light sensor's lead ([sheet 06](#sheet-06-light-sensor-v3)), the only wiring inside the clock is power: one 5 V USB-C inlet feeds the reSpeaker, and the CrowPanel is fed from the reSpeaker's spare 5V and GND header pins on its LED side. The speaker plugs into the reSpeaker and the mute button is mechanical, so neither needs any soldering.

The chain is **USB-C inlet → disconnect → reSpeaker header → CrowPanel**. The only wire opening in the stack is the carrier's centre hole, and nothing runs round the reSpeaker's edge, so the light ring, carrier and rear shell need no cable notch or gap.

**Printable version:** [`wiring_sheets.pdf`](wiring_sheets.pdf) (5 landscape pages, one per sheet below). Print it and keep it on the bench.

**Time:** about 1 hour, including the bench checks.

---

## What to buy (on top of the main parts list)

| Qty | Part | Notes |
|---|---|---|
| 1 | MX1.25 4-pin pigtail, 10–15 cm (often sold as "Molex PicoBlade 1.25 mm 4P") | Goes into the CrowPanel's power port. Buy a pack; they're cheap. Keep the supplied USB cable intact for bench flashing. |
| 1 pair | 2-pin wire-to-wire connector, ≥ 3 A, 22 AWG leads: **JST-SM** (LED-strip type) or **JST-XH** male/female | The back-plate disconnect. JST-PH isn't suitable: its crimps only take 24–32 AWG and it's rated 2 A. |
| — | Silicone wire: 22 AWG red + black | About 30 cm of each is plenty |
| — | Heat shrink: 1.5, 2.5 and 4.8 mm | |
| 1 | **v3:** STEMMA QT / Qwiic cable (JST SH 1.0 mm 4-pin), 100–150 mm | The light-sensor lead. Cut one plug off; one cable makes two leads. |
| 1 | 470 µF / 10 V electrolytic capacitor (optional) | Smooths amp peaks at the B–C splice |
| — | Flux-core solder (0.6–0.8 mm), flux pen, hot glue, small zip ties | |

## Cut list

Cut everything long and trim it at the test fit (sheet 05).

| Lead | Wire | Length | From | To |
|---|---|---|---|---|
| **A** | 22 AWG red + black | 10 cm | USB-C breakout VBUS / GND | Disconnect, **socket** half |
| **B** | 22 AWG (the connector's own leads) | 3 cm | Disconnect, **pin** half | Inline splice to C |
| **C** | 22 AWG red + black | 10 cm | Inline splice to B, through the carrier's centre hole | reSpeaker header, from the back: 5V (row 1 right), GND (row 2 left) |
| **D** | MX1.25 pigtail (28 AWG, as bought) | trim to ~6 cm | reSpeaker header, from the LED side: 5V (row 2 right), GND (row 3 right) | CrowPanel power port |

---

## Sheet 01: the whole circuit

Wiring diagram

The current budget is about 3 A peak in total: the reSpeaker takes up to about 1.6 A (amp peaks plus a full-white LED ring) and the CrowPanel up to about 1 A. All of it comes in on lead C; the CrowPanel's share crosses the header from the row 1 / row 2 pins to the row 2 / row 3 pins on the same 5V and GND nets. Use a 5 V 3 A charger.

## Sheet 02: reSpeaker, 5 V and GND (power in, CrowPanel out)

reSpeaker solder points

Solder to the **2×10 through-hole header** on the back of the board, not to the XIAO. Through-hole joints are much stronger than surface pads, and the header carries the board's 5 V rail.

1. **Check first:** power the reSpeaker from its own USB-C on the bench and measure the header's **5V** (row 1, right) to **GND** (row 2, left). You should read about 5.0 V. Unplug it, then beep the header 5V to the XIAO's 5V pin. It should beep. If either check fails, stop and look at Seeed's pinout before going on.
2. Slide 2.5 mm heat shrink onto each wire of lead C. Strip 2–3 mm and tin the ends.
3. Push the red wire into **row 1, right (5V)** from the back side. Solder it on the LED side and trim it to 1 mm or less. That side has only a 5 mm gap to the spider.
4. Push the black wire into **row 2, left (GND)** the same way. It's on a ground plane, so use about 370 °C and hold the iron there for 3–4 s until the solder flows round the hole.
5. **VDDIO is right next to the 5V hole and is not 5 V.** Check under a light that nothing bridges them.
6. **Lead D (CrowPanel):** push the pigtail's 5 V wire into **row 2, right (5V)** and its GND wire into **row 3, right (GND)**, this time **from the LED side**, and solder them on the back. Trim them flat on the LED side: the wires lie across the 5 mm gap to the spider. Both holes are inside the light ring (the header is about 26–32 mm from the board centre, the ring's inner wall at 37 mm), so the lead never goes near the board edge.
7. Hot-glue lead C to the board's back about 10 mm from the joints, away from the mic holes.

## Sheet 03: CrowPanel via a plug-in pigtail

CrowPanel pigtail

Elecrow's schematic only brings 5 V into the CrowPanel's main board through its 12-pin FPC (pins 1–2 = 5 V, 11–12 = GND) and a tiny test pad. Rather than soldering to the display, feed 5 V into the same 4-pin port that the supplied MX1.25-to-USB cable uses, from the reSpeaker header.

1. **Find the pins.** Plug the supplied cable into a USB charger. With a sewing needle taped to each meter probe, probe pairs of contacts in the MX1.25 plug until you read **+5.0 V**. The red probe is on 5 V and the black probe on GND. Note both positions.
2. On the spare pigtail, identify those **same positions**. Its wire colours mean nothing.
3. Cut the other two wires (D+ and D−) 5 mm back, and sleeve each one separately in 1.5 mm shrink.
4. Trim the pigtail to about 6 cm, strip 2 mm of the 5 V and GND wires and tin them. They go straight into the reSpeaker header (sheet 02 step 6): no splice.
5. **Test:** with lead D soldered, power the reSpeaker from its own USB-C on the bench and plug the pigtail into the panel. The clock face should boot.

## Sheet 04: inlet, disconnect, B–C splice

Inlet, disconnect and B–C splice

- **USB-C breakout:** solder lead A to **VBUS** and **GND**, going by the silkscreen. Leave CC1, CC2, D+ and D− alone. Check that CC1 to GND and CC2 to GND each read about 5.1 kΩ. Without those resistors a USB-C charger supplies nothing.
- **Disconnect:** the **socket** (shrouded) half goes on the inlet side, so a loose lead can't short. Pin 1 is red.
- **B–C splice:** thread lead C through the carrier's centre hole first. Then, for each colour, slide 2.5 mm shrink on, lay B and C side by side, twist, solder and shrink. Stagger the red and black joints by 15 mm. If you're fitting the capacitor, solder its long leg into the red joint and its striped short leg into the black joint before you shrink them.

## Sheet 05: the route inside the case

Cable route

Keep splices, heat shrink and loops out of the 5 mm gap between the spider and the reSpeaker. Only the bare pigtail (lead D) passes there, from the header's spare pins to the CrowPanel's power port, and all of it stays inside the light ring. Every splice sits behind the carrier.

Lead C and the speaker lead pass through the carrier's centre hole, the only wire opening in the stack. Nothing runs round the reSpeaker's edge, so the whole electronics stack, with every lead plugged in, drops into the rear shell at its keyed angle in one piece, and the front shell then twist-locks on with no wires attached to it, so it can come off without unplugging anything.

---

## Power-up checklist

Do these in order. Stop at the first one that fails.

1. With nothing plugged in, measure 5 V to GND at the disconnect's pin half. It must **not** read 0 Ω.
2. Plug the charger into the inlet and meter the socket half: **+5.0 V** with the red probe on pin 1.
3. Unplug the charger, join the disconnect, and plug the charger back in. The clock face boots and the reSpeaker's LED ring lights.
4. Play audio loud (with the volume capped in ESPHome). Header 5V to GND should stay above 4.75 V.
5. Tug each lead gently. Nothing should move at a joint; the hot glue or ties should take the load.

**Back-feed rule:** never plug a laptop into either board while the inlet is powered.

## Sheet 06: light sensor (v3)

*Optional, for the untested light-sensor variant only (`print/v3_light_sensor`). Not in the printable PDF yet.*

The Adafruit #5378 VEML7700 board joins the XIAO's I2C bus, which the XIAO already uses to talk to the XVF3800 (address 0x2C; the VEML7700 is 0x10). The board has its own 3.3 V regulator, level shifting and 10 kΩ pull-ups, so it runs from the XIAO's 3V3.

| STEMMA QT wire | Signal | XIAO pin (on the back of the reSpeaker) |
|---|---|---|
| Red | VIN | **3V3** |
| Black | GND | **GND** |
| Blue | SDA | **D4** (GPIO5, labelled I2C_SDA on Seeed's pinout) |
| Yellow | SCL | **D5** (GPIO6, labelled I2C_SCL) |

1. **Check the colours first.** Some generic Qwiic cables don't use Adafruit's colours. Plug the cable into the sensor board and beep each wire against the board's VIN, GND, SDA and SCL pads.
2. Cut the plug off one end, leaving about 120 mm of lead. Strip 2 mm and tin each wire.
3. Solder the 4 wires to the tops of the XIAO's castellated pins, on the board's back, and slip 1.5 mm heat shrink over each joint. **3V3, not 5V**: they're next to each other in the XIAO's right-hand column.
4. **Route.** From the XIAO (3 o'clock seen from the front), run the lead round behind the reSpeaker to about 1 o'clock, through the 5 mm notch in the carrier's rim (between the key rib and the mute button), then back to the sensor board at 12 o'clock behind the carrier. It plugs into the board's right-hand socket (seen from the front).
5. **Bench check:** flash the reSpeaker with `firmware/respeaker-light-sensor.yaml` added. Its log should show the VEML7700 found at 0x10 during the I2C scan, and **Ambient Light** in HA should follow a torch held over the sensor.

## v2 note: the UART link

The CrowPanel's UART pins are level-shifted to **5 V logic** (BSN20 MOSFETs pulled up to 5 V in Elecrow's schematic). The XIAO ESP32-S3 is 3.3 V only. For a future ESP-to-ESP link, add a level shifter. Don't run those wires for v1.

## Sources and what still needs checking

- reSpeaker header labels: Seeed's pinout image (`files.seeedstudio.com/wiki/respeaker_xvf3800_usb/pinout.jpg`), from the [XVF3800 + XIAO getting-started wiki](https://wiki.seeedstudio.com/respeaker_xvf3800_xiao_getting_started/). CNX Software's spec summary gives "5 V via USB or pin header".
- CrowPanel power nets and the UART level shifters: Elecrow's schematic `ESP32_Display_2.1(K)_Main_V1.0` in the [CrowPanel 2.1 GitHub repo](https://github.com/Elecrow-RD/CrowPanel-2.1inch-HMI-ESP32-Rotary-Display-480-480-IPS-Round-Touch-Knob-Screen).
- **Not confirmed by vendor docs, so check with a meter (the steps above include it):**
  - that the header's 5V feeds both the XVF3800 and the XIAO
  - which of the CrowPanel's rear ports is the power port, and its pin order
  - the pad names on your USB-C breakout
  - v3: the XIAO pin names in the table above (from Seeed's pinout image) and your Qwiic cable's wire colours
