asherflynt/voice-clock/firmware/voice-clock.yaml

# Voice Clock – CrowPanel 2.1" rotary display
# Analog clock face + device control page (knob and touch).
# Hardware init follows Elecrow's ESPHome Lesson 05 for the CrowPanel 2.1" (see firmware/README.md).

esphome:
  name: voice-clock
  friendly_name: Voice Clock
  includes:
    - voice_clock.h
  platformio_options:
    build_flags: "-DBOARD_HAS_PSRAM"
    board_build.esp-idf.memory_type: qio_opi
    board_build.flash_mode: dio
  on_boot:
    - priority: 800
      then:
        # Panel power on, then pulse reset. The panel stays dark without this.
        - output.turn_on: touch_int_release
        - output.turn_on: lcd_power
        - output.turn_on: display_reset
        - delay: 100ms
        - output.turn_off: display_reset
        - delay: 600ms
        - light.turn_on:
            id: display_backlight
            brightness: 0.6

esp32:
  board: esp32-s3-devkitc-1
  flash_size: 16MB
  framework:
    type: esp-idf
    sdkconfig_options:
      CONFIG_ESP32S3_DEFAULT_CPU_FREQ_240: y
      CONFIG_ESP32S3_DATA_CACHE_64KB: y
      CONFIG_SPIRAM_FETCH_INSTRUCTIONS: y
      CONFIG_SPIRAM_RODATA: y

packages:
  lamp_1: !include
    file: ha_light.yaml
    vars:
      idx: 0
      entity: light.lamp_1            # <- your HA light
  lamp_2: !include
    file: ha_light.yaml
    vars:
      idx: 1
      entity: light.lamp_2            # <- your HA light
  reading_light: !include
    file: ha_light.yaml
    vars:
      idx: 2
      entity: light.reading_light     # <- your HA light

globals:
  - id: dev_idx          # selected device, index into vc::NAMES
    type: int
    initial_value: '0'
  - id: ui_mode          # 0 = browse devices, 1 = adjust selected device
    type: int
    initial_value: '0'
  - id: on_clock
    type: bool
    initial_value: 'true'
  - id: levels           # 0-100 per device
    type: std::array<int, 5>
    initial_value: '{0, 0, 0, 0, 60}'
  - id: states_on        # lights: on; voice: not muted
    type: std::array<bool, 5>
    initial_value: '{false, false, false, true, true}'
  - id: sun_down
    type: bool
    initial_value: 'false'
  - id: room_lux         # v3 light sensor on the reSpeaker; NAN while it isn't reporting
    type: float
    initial_value: 'NAN'
  - id: night
    type: bool
    initial_value: 'false'
  - id: day_brightness   # screen level to restore when night mode ends
    type: int
    initial_value: '60'
  - id: alarm_enabled
    type: bool
    initial_value: 'false'
  - id: alarm_time_str   # "HH:MM:SS" from the reSpeaker
    type: std::string
  - id: timer_active
    type: bool
    initial_value: 'false'
  - id: timer_end_ms     # millis() when the first active timer reaches 0
    type: uint32_t
    initial_value: '0'
  - id: timer_total_s    # largest seconds-left seen for this timer, for the ring
    type: int
    initial_value: '0'
  - id: last_local_ms
    type: std::array<uint32_t, 5>
    initial_value: '{0, 0, 0, 0, 0}'

psram:
  mode: octal
  speed: 80MHz

logger:
  level: DEBUG

api:
  encryption:
    key: !secret api_encryption_key

ota:
  - platform: esphome
    password: !secret ota_password

wifi:
  ssid: !secret wifi_ssid
  password: !secret wifi_password
  ap:
    ssid: "Voice-Clock-Fallback"
    password: !secret fallback_ap_password

captive_portal:

i2c:
  sda: GPIO38
  scl: GPIO39
  id: bus_a
  scan: true

# PCF8574 pins:
# P0 touch reset, P2 touch interrupt, P3 LCD power, P4 LCD reset, P5 knob button
pcf8574:
  - id: pcf
    address: 0x21

output:
  - platform: ledc
    pin: 6
    id: bl_pwm
    frequency: 19531Hz

  - platform: gpio
    id: touch_int_release
    pin:
      pcf8574: pcf
      number: 2
      mode:
        output: true
      inverted: false

  - platform: gpio
    id: lcd_power
    pin:
      pcf8574: pcf
      number: 3
      mode:
        output: true
      inverted: false

  - platform: gpio
    id: display_reset
    pin:
      pcf8574: pcf
      number: 4
      mode:
        output: true
      inverted: true

light:
  - platform: monochromatic
    name: "LCD Backlight"
    output: bl_pwm
    id: display_backlight
    default_transition_length: 0s
    restore_mode: ALWAYS_ON
    on_state:
      - lambda: |-
          id(levels)[vc::SCREEN_IDX] = (int) lroundf(id(display_backlight).remote_values.get_brightness() * 100);
      - script.execute: refresh_ui

sensor:
  - platform: rotary_encoder
    id: knob
    internal: true
    # Pins swapped from Elecrow's sample so clockwise counts up.
    pin_a:
      number: 4
      mode:
        input: true
        pullup: true
    pin_b:
      number: 42
      mode:
        input: true
        pullup: true
    # One count per detent click (this encoder clicks twice per quadrature cycle).
    resolution: 2
    filters:
      - debounce: 20ms
    on_clockwise:
      - script.execute:
          id: knob_step
          dir: 1
    on_anticlockwise:
      - script.execute:
          id: knob_step
          dir: -1

  # reSpeaker next timer: seconds left, -1 when none. Updated every 5 s; counted down locally.
  - platform: homeassistant
    id: ha_next_timer
    entity_id: sensor.${voice_sat}_next_timer
    internal: true
    on_value:
      - lambda: |-
          if (std::isnan(x) || x <= 0) {
            id(timer_active) = false;
            id(timer_total_s) = 0;
          } else {
            int s = (int) x;
            if (!id(timer_active) || s > id(timer_total_s)) id(timer_total_s) = s;
            id(timer_active) = true;
            id(timer_end_ms) = millis() + (uint32_t) s * 1000;
          }
      - script.execute: update_overlays

  # v3: room light level from the VEML7700 on the reSpeaker (firmware/respeaker-light-sensor.yaml).
  - platform: homeassistant
    id: ha_lux
    entity_id: ${lux_sensor}
    internal: true
    on_value:
      - lambda: 'id(room_lux) = x;'
      - script.execute: eval_night

  # Music player volume (0-1) and mute.
  - platform: homeassistant
    id: ha_volume
    entity_id: ${music_player}
    attribute: volume_level
    internal: true
    on_value:
      - lambda: |-
          if (std::isnan(x) || millis() - id(last_local_ms)[vc::MUSIC_IDX] < vc::ECHO_IGNORE_MS) return;
          id(levels)[vc::MUSIC_IDX] = (int) lroundf(x * 100);
      - script.execute: refresh_ui

text_sensor:
  - platform: homeassistant
    id: ha_sun
    entity_id: sun.sun
    internal: true
    on_value:
      - lambda: 'id(sun_down) = (x == "below_horizon");'
      - script.execute: eval_night

  - platform: homeassistant
    id: ha_alarm_on
    entity_id: switch.${voice_sat}_alarm_on
    internal: true
    on_value:
      - lambda: 'id(alarm_enabled) = (x == "on");'
      - script.execute: update_overlays

  - platform: homeassistant
    id: ha_alarm_time
    entity_id: time.${voice_sat}_alarm_time
    internal: true
    on_value:
      - lambda: 'id(alarm_time_str) = x;'
      - script.execute: update_overlays

  - platform: homeassistant
    id: ha_muted
    entity_id: ${music_player}
    attribute: is_volume_muted
    internal: true
    on_value:
      - lambda: |-
          id(states_on)[vc::MUSIC_IDX] = !(x == "True" || x == "true" || x == "on");
      - script.execute: refresh_ui

number:
  - platform: template
    id: night_brightness
    name: "Night Brightness"
    icon: mdi:brightness-4
    unit_of_measurement: "%"
    min_value: 1
    max_value: 50
    step: 1
    initial_value: 12
    restore_value: true
    optimistic: true
    entity_category: config
    on_value:
      - if:
          condition:
            lambda: 'return id(night);'
          then:
            - light.turn_on:
                id: display_backlight
                brightness: !lambda 'return x / 100.0f;'

  - platform: template
    id: night_lux
    name: "Night Light Level"
    icon: mdi:brightness-6
    unit_of_measurement: "lx"
    min_value: 0.5
    max_value: 50
    step: 0.5
    initial_value: 3
    restore_value: true
    optimistic: true
    entity_category: config
    on_value:
      - script.execute: eval_night

switch:
  - platform: template
    id: force_night
    name: "Force Night Mode"
    icon: mdi:weather-night
    optimistic: true
    restore_mode: RESTORE_DEFAULT_OFF
    on_turn_on:
      - script.execute: eval_night
    on_turn_off:
      - script.execute: eval_night

binary_sensor:
  # reSpeaker microphone mute (the plunger on top). Shown as an icon on the clock face.
  - platform: homeassistant
    id: mic_muted
    entity_id: switch.${voice_sat}_microphone_mute
    internal: true
    on_state:
      - script.execute: update_overlays

  - platform: template
    id: night_mode
    name: "Night Mode"
    icon: mdi:weather-night
    lambda: 'return id(night);'

  - platform: gpio
    id: knob_button
    internal: true
    pin:
      pcf8574: pcf
      number: 5
      mode:
        input: true
      inverted: true
    filters:
      - delayed_on_off: 30ms
    on_click:
      - min_length: 20ms
        max_length: 700ms
        then:
          - script.execute: knob_press
      # Long press: back to the clock.
      - min_length: 900ms
        max_length: 5s
        then:
          - script.execute: show_clock

touchscreen:
  - platform: cst816
    id: touch_panel
    display: my_display
    reset_pin:
      pcf8574: pcf
      number: 0
      mode:
        output: true
      inverted: false
    update_interval: 50ms
    on_touch:
      then:
        - logger.log:
            format: "Touch at %d, %d"
            args: ["touch.x", "touch.y"]

time:
  - platform: homeassistant
    id: ha_time
    on_time:
      # Timer countdown / alarm label every second; hands once a minute (no second hand).
      - seconds: /1
        then:
          - script.execute: update_overlays
      - seconds: 0
        then:
          - script.execute: update_hands
    on_time_sync:
      then:
        - script.execute: update_hands

script:
  # Night mode: the room is dark (v3 light sensor: below "Night Light Level", back to day above
  # twice that). Without a sensor reading: all bedroom lamps off and the sun is down.
  - id: eval_night
    then:
      - if:
          condition:
            lambda: |-
              bool want;
              float lx = id(room_lux);
              if (!std::isnan(lx)) {
                float t = id(night_lux).state;
                want = id(night) ? (lx < 2.0f * t) : (lx < t);
              } else {
                want = id(sun_down);
                for (int i = 0; i < vc::MUSIC_IDX; i++) want = want && !id(states_on)[i];
              }
              want = want || id(force_night).state;
              return want != id(night);
          then:
            - lambda: |-
                id(night) = !id(night);
                if (id(night)) id(day_brightness) = std::max(5, id(levels)[vc::SCREEN_IDX]);
                id(night_mode).publish_state(id(night));
                ESP_LOGI("night", "Night mode %s", id(night) ? "ON" : "OFF");
            - script.execute: apply_theme
            - light.turn_on:
                id: display_backlight
                brightness: !lambda |-
                  return id(night) ? id(night_brightness).state / 100.0f : id(day_brightness) / 100.0f;

  - id: apply_theme
    then:
      - lambda: |-
          bool n = id(night);
          auto c = [](uint32_t hex) { return lv_color_hex(hex); };
          uint32_t bg = n ? 0x000000 : 0xFCEBEC;
          // Night is grayscale: light greys on black stay readable at a low backlight.
          uint32_t num = n ? 0xB4B4B4 : 0x6E0A1E;
          uint32_t tick = n ? 0x6E6E6E : 0x6E0A1E;
          lv_obj_set_style_bg_color(id(clock_page).obj, c(bg), LV_PART_MAIN);
          lv_obj_set_style_bg_color(id(control_page).obj, c(bg), LV_PART_MAIN);
          for (auto *l : {id(num12), id(num3), id(num6), id(num9)})
            lv_obj_set_style_text_color(l, c(num), LV_PART_MAIN);
          for (auto *t : {id(tick0), id(tick1), id(tick2), id(tick3), id(tick4), id(tick5), id(tick6), id(tick7)})
            lv_obj_set_style_line_color(t->obj, c(tick), LV_PART_MAIN);
          lv_obj_set_style_line_color(id(hour_hand)->obj, c(n ? 0x8C8C8C : 0xF08090), LV_PART_MAIN);
          lv_obj_set_style_line_color(id(minute_hand)->obj, c(n ? 0xD2D2D2 : 0xD8404F), LV_PART_MAIN);
          for (auto *l : {id(lbl_name), id(lbl_value)})
            lv_obj_set_style_text_color(l, c(n ? 0xB4B4B4 : 0x6E0A1E), LV_PART_MAIN);
          lv_obj_set_style_text_color(id(lbl_status), c(n ? 0x7A7A7A : 0x9A4A5A), LV_PART_MAIN);
          lv_obj_set_style_text_color(id(lbl_alarm), c(n ? 0x7A7A7A : 0x9A4A5A), LV_PART_MAIN);
          lv_obj_set_style_text_color(id(lbl_mute), c(n ? 0xDCDCDC : 0xD8404F), LV_PART_MAIN);
          lv_obj_set_style_text_color(id(lbl_timer), c(n ? 0x9A9A9A : 0x3BA7DC), LV_PART_MAIN);
          lv_obj_set_style_arc_color(id(timer_arc), c(n ? 0x9A9A9A : 0x3BA7DC), LV_PART_INDICATOR);
          // Centre dot of the hands (the meter's 26 px pivot child).
          for (uint32_t k = 0; k < lv_obj_get_child_count(id(clock_meter)); k++) {
            lv_obj_t *ch = lv_obj_get_child(id(clock_meter), k);
            if (lv_obj_get_style_width(ch, LV_PART_MAIN) == 26)
              lv_obj_set_style_bg_color(ch, c(n ? 0xD2D2D2 : 0xD8404F), LV_PART_MAIN);
          }
          // Control page: level arc, its knob, and the three buttons with their icons.
          lv_obj_set_style_arc_color(id(arc_level), c(n ? 0x2E2E2E : 0xF3D3D6), LV_PART_MAIN);
          lv_obj_set_style_arc_color(id(arc_level), c(n ? 0xC8C8C8 : 0xD8404F), LV_PART_INDICATOR);
          lv_obj_set_style_bg_color(id(arc_level), c(n ? 0xE6E6E6 : 0x6E0A1E), LV_PART_KNOB);
          for (auto *b : {id(btn_prev), id(btn_next), id(btn_home)}) {
            lv_obj_set_style_bg_color(b, c(n ? 0x2E2E2E : 0xF3D3D6), LV_PART_MAIN);
            if (lv_obj_get_child_count(b) > 0)
              lv_obj_set_style_text_color(lv_obj_get_child(b, 0), c(n ? 0xB4B4B4 : 0x6E0A1E), LV_PART_MAIN);
          }
      - script.execute: refresh_ui   # device dots follow the theme

  # Redraw the control page from levels / states_on / dev_idx / ui_mode.
  - id: refresh_ui
    then:
      - lambda: |-
          int i = id(dev_idx);
          int v = id(levels)[i];
          bool adj = id(ui_mode) == 1;
          lv_label_set_text(id(lbl_name), vc::NAMES[i]);
          lv_label_set_text(id(lbl_value), (std::to_string(v) + "%").c_str());
          lv_arc_set_value(id(arc_level), v);
          const char *st;
          if (i == vc::SCREEN_IDX) st = "Brightness";
          else if (i == vc::MUSIC_IDX) st = id(states_on)[i] ? "Volume" : "Muted";
          else st = id(states_on)[i] ? "On" : "Off";
          lv_label_set_text(id(lbl_status), st);
          lv_obj_set_style_arc_opa(id(arc_level), adj ? LV_OPA_COVER : LV_OPA_40, LV_PART_INDICATOR);
          lv_obj_set_style_opa(id(arc_level), adj ? LV_OPA_COVER : LV_OPA_0, LV_PART_KNOB);
          if (adj) {
            lv_obj_add_flag(id(arc_level), LV_OBJ_FLAG_CLICKABLE);
            lv_obj_add_flag(id(btn_prev), LV_OBJ_FLAG_HIDDEN);
            lv_obj_add_flag(id(btn_next), LV_OBJ_FLAG_HIDDEN);
          } else {
            lv_obj_remove_flag(id(arc_level), LV_OBJ_FLAG_CLICKABLE);
            lv_obj_remove_flag(id(btn_prev), LV_OBJ_FLAG_HIDDEN);
            lv_obj_remove_flag(id(btn_next), LV_OBJ_FLAG_HIDDEN);
          }
          lv_obj_t *dots[vc::DEVICE_COUNT] = {id(dot0), id(dot1), id(dot2), id(dot3), id(dot4)};
          for (int k = 0; k < vc::DEVICE_COUNT; k++)
            lv_obj_set_style_bg_color(dots[k], lv_color_hex(k == i ? (id(night) ? 0xD2D2D2 : 0xD8404F)
                                                                    : (id(night) ? 0x3C3C3C : 0xEBC2C7)), LV_PART_MAIN);

  - id: idle_timer
    mode: restart
    then:
      - delay: 10s
      - script.execute: show_clock

  - id: show_clock
    then:
      - lambda: 'id(ui_mode) = 0; id(on_clock) = true;'
      - lvgl.page.show: clock_page

  - id: open_control
    then:
      - lambda: 'id(ui_mode) = 0; id(on_clock) = false;'
      - script.execute: refresh_ui
      - lvgl.page.show: control_page
      - script.execute: idle_timer

  # One knob detent (or arrow tap). On the clock the same click also opens the
  # control page, so no turn is wasted.
  - id: knob_step
    parameters:
      dir: int
    then:
      - if:
          condition:
            lambda: 'return id(on_clock);'
          then:
            - script.execute: open_control
      - script.execute: idle_timer
      - if:
          condition:
            lambda: 'return id(ui_mode) == 0;'
          then:
            - lambda: 'id(dev_idx) = (id(dev_idx) + dir + vc::DEVICE_COUNT) % vc::DEVICE_COUNT;'
          else:
            - lambda: |-
                int i = id(dev_idx);
                int v = std::max(i == vc::SCREEN_IDX ? 5 : 0, std::min(100, id(levels)[i] + dir * 5));
                id(levels)[i] = v;
                id(last_local_ms)[i] = millis();
            - script.execute:
                id: apply_level
                idx: !lambda 'return id(dev_idx);'
                level: !lambda 'return id(levels)[id(dev_idx)];'
      - script.execute: refresh_ui

  - id: knob_press
    then:
      - if:
          condition:
            lambda: 'return id(on_clock);'
          then:
            - script.execute: open_control
          else:
            - lambda: 'id(ui_mode) = 1 - id(ui_mode);'
            - script.execute: refresh_ui
            - script.execute: idle_timer

  # Tap in the middle of the control page: select in browse mode, on/off (or mute) in adjust mode.
  - id: center_tap
    then:
      - script.execute: idle_timer
      - if:
          condition:
            lambda: 'return id(ui_mode) == 0;'
          then:
            - lambda: 'id(ui_mode) = 1;'
          else:
            - script.execute:
                id: toggle_device
                idx: !lambda 'return id(dev_idx);'
      - script.execute: refresh_ui

  # Send a level to HA. Restart mode + delay = one call per burst of knob turns.
  - id: apply_level
    mode: restart
    parameters:
      idx: int
      level: int
    then:
      - if:
          condition:
            lambda: 'return idx == vc::SCREEN_IDX;'
          then:
            - light.turn_on:
                id: display_backlight
                brightness: !lambda 'return level / 100.0f;'
          else:
            - delay: 300ms
            - if:
                condition:
                  lambda: 'return idx == vc::MUSIC_IDX;'
                then:
                  - homeassistant.action:
                      action: media_player.volume_set
                      data:
                        entity_id: ${music_player}
                        volume_level: !lambda 'return str_sprintf("%.2f", level / 100.0f);'
                else:
                  - if:
                      condition:
                        lambda: 'return level == 0;'
                      then:
                        - homeassistant.action:
                            action: light.turn_off
                            data:
                              entity_id: !lambda 'return std::string(vc::ENTITIES[idx]);'
                      else:
                        - homeassistant.action:
                            action: light.turn_on
                            data:
                              entity_id: !lambda 'return std::string(vc::ENTITIES[idx]);'
                              brightness_pct: !lambda 'return std::to_string(level);'

  - id: toggle_device
    parameters:
      idx: int
    then:
      - lambda: 'if (idx != vc::SCREEN_IDX) id(states_on)[idx] = !id(states_on)[idx];'
      - if:
          condition:
            lambda: 'return idx < vc::MUSIC_IDX;'
          then:
            - homeassistant.action:
                action: light.toggle
                data:
                  entity_id: !lambda 'return std::string(vc::ENTITIES[idx]);'
      - if:
          condition:
            lambda: 'return idx == vc::MUSIC_IDX;'
          then:
            - homeassistant.action:
                action: media_player.volume_mute
                data:
                  entity_id: ${music_player}
                  is_volume_muted: !lambda 'return std::string(id(states_on)[idx] ? "false" : "true");'

  # Alarm time under the 12 and timer countdown ring + text above the 6.
  - id: update_overlays
    then:
      - lambda: |-
          char buf[24];
          // Alarm
          int h, m;
          bool alarm = id(alarm_enabled) && sscanf(id(alarm_time_str).c_str(), "%d:%d", &h, &m) == 2;
          if (alarm) {
            snprintf(buf, sizeof(buf), "\uF0F3 %d:%02d %s", (h % 12) ? h % 12 : 12, m, h < 12 ? "AM" : "PM");
            // Only on change: every set_text redraws the label.
            if (strcmp(lv_label_get_text(id(lbl_alarm)), buf) != 0)
              lv_label_set_text(id(lbl_alarm), buf);
            lv_obj_remove_flag(id(lbl_alarm), LV_OBJ_FLAG_HIDDEN);
          } else {
            lv_obj_add_flag(id(lbl_alarm), LV_OBJ_FLAG_HIDDEN);
          }
          // Mic mute
          bool muted = id(mic_muted).has_state() && id(mic_muted).state;
          if (muted != !lv_obj_has_flag(id(lbl_mute), LV_OBJ_FLAG_HIDDEN)) {
            if (muted)
              lv_obj_remove_flag(id(lbl_mute), LV_OBJ_FLAG_HIDDEN);
            else
              lv_obj_add_flag(id(lbl_mute), LV_OBJ_FLAG_HIDDEN);
          }
          // Timer
          if (id(timer_active)) {
            int32_t left_ms = (int32_t) (id(timer_end_ms) - millis());
            int left = left_ms > 0 ? (left_ms + 999) / 1000 : 0;
            if (left >= 3600)
              snprintf(buf, sizeof(buf), "%d:%02d:%02d", left / 3600, (left / 60) % 60, left % 60);
            else
              snprintf(buf, sizeof(buf), "%d:%02d", left / 60, left % 60);
            lv_label_set_text(id(lbl_timer), buf);
            int total = std::max(1, id(timer_total_s));
            lv_arc_set_value(id(timer_arc), std::min(1000, left * 1000 / total));
            lv_obj_remove_flag(id(lbl_timer), LV_OBJ_FLAG_HIDDEN);
            lv_obj_remove_flag(id(timer_arc), LV_OBJ_FLAG_HIDDEN);
          } else {
            lv_obj_add_flag(id(lbl_timer), LV_OBJ_FLAG_HIDDEN);
            lv_obj_add_flag(id(timer_arc), LV_OBJ_FLAG_HIDDEN);
          }

  - id: update_hands
    then:
      - if:
          condition:
            lambda: 'return id(ha_time).now().is_valid();'
          then:
            - lvgl.indicator.update:
                id: hour_hand
                value: !lambda |-
                  auto t = id(ha_time).now();
                  return (t.hour % 12) * 60 + t.minute;
            - lvgl.indicator.update:
                id: minute_hand
                value: !lambda |-
                  auto t = id(ha_time).now();
                  return t.minute * 60;

font:
  - file:
      type: gfonts
      family: Fredoka
      weight: 600
    id: font_numerals
    size: 92
    glyphs: "12369"
  - file:
      type: gfonts
      family: Fredoka
      weight: 600
    id: font_value
    size: 96
    glyphs: "0123456789%"
  - file:
      type: gfonts
      family: Fredoka
      weight: 500
    id: font_name
    size: 36
  - file:
      type: gfonts
      family: Fredoka
      weight: 400
    id: font_small
    size: 22
  # Material Design Icons, only the mic-off glyph.
  - file: "https://github.com/Templarian/MaterialDesign-Webfont/raw/v7.4.47/fonts/materialdesignicons-webfont.ttf"
    id: font_icons
    size: 48
    glyphs: ["\U000F036D"]

spi:
  clk_pin: 2
  mosi_pin: 1

display:
  - platform: st7701s
    id: my_display
    auto_clear_enabled: false
    update_interval: never
    spi_mode: MODE3
    color_order: RGB
    invert_colors: false
    dimensions:
      width: 480
      height: 480
    cs_pin: 16
    de_pin: 40
    hsync_pin: 15
    vsync_pin: 7
    pclk_pin: 41
    data_pins:
      red: [46, 3, 8, 18, 17]
      green: [14, 13, 12, 11, 10, 9]
      blue: [5, 45, 48, 47, 21]
    hsync_front_porch: 20
    hsync_pulse_width: 10
    hsync_back_porch: 10
    vsync_front_porch: 8
    vsync_pulse_width: 10
    vsync_back_porch: 10
    pclk_frequency: 18MHz
    pclk_inverted: true
    # ST7701S init sequence from Elecrow's CrowPanel 2.1" ESPHome Lesson 05 (21-touch.yaml):
    # https://github.com/Elecrow-RD/CrowPanel-2.1inch-HMI-ESP32-Rotary-Display-480-480-IPS-Round-Touch-Knob-Screen
    init_sequence:
      - [0x01]
      - delay 120ms
      - [0xFF, 0x77, 0x01, 0x00, 0x00, 0x10]
      - [0xC0, 0x3B, 0x00]
      - [0xC1, 0x0B, 0x02]
      - [0xC2, 0x00, 0x02]
      - [0xCC, 0x10]
      - [0xCD, 0x08]
      - [0xB0, 0x02, 0x13, 0x1B, 0x0D, 0x10, 0x05, 0x08, 0x07, 0x07, 0x24, 0x04, 0x11, 0x0E, 0x2C, 0x33, 0x1D]
      - [0xB1, 0x05, 0x13, 0x1B, 0x0D, 0x11, 0x05, 0x08, 0x07, 0x07, 0x24, 0x04, 0x11, 0x0E, 0x2C, 0x33, 0x1D]
      - [0xFF, 0x77, 0x01, 0x00, 0x00, 0x11]
      - [0xB0, 0x5D]
      - [0xB1, 0x43]
      - [0xB2, 0x81]
      - [0xB3, 0x80]
      - [0xB5, 0x43]
      - [0xB7, 0x85]
      - [0xB8, 0x20]
      - [0xC1, 0x78]
      - [0xC2, 0x78]
      - [0xD0, 0x88]
      - [0xE0, 0x00, 0x00, 0x02]
      - [0xE1, 0x03, 0xA0, 0x00, 0x00, 0x04, 0xA0, 0x00, 0x00, 0x00, 0x20, 0x20]
      - [0xE2, 0x00, 0x00, 0x00, 0x00, 0x00, 0x00, 0x00, 0x00, 0x00, 0x00, 0x00, 0x00, 0x00, 0x00, 0x00]
      - [0xE3, 0x00, 0x00, 0x11, 0x00]
      - [0xE4, 0x22, 0x00]
      - [0xE5, 0x05, 0xEC, 0xA0, 0xA0, 0x07, 0xEE, 0xA0, 0xA0, 0x00, 0x00, 0x00, 0x00, 0x00, 0x00, 0x00, 0x00]
      - [0xE6, 0x00, 0x00, 0x11, 0x00]
      - [0xE7, 0x22, 0x00]
      - [0xE8, 0x06, 0xED, 0xA0, 0xA0, 0x08, 0xEF, 0xA0, 0xA0, 0x00, 0x00, 0x00, 0x00, 0x00, 0x00, 0x00, 0x00]
      - [0xEB, 0x00, 0x00, 0x40, 0x40, 0x00, 0x00, 0x00]
      - [0xED, 0xFF, 0xFF, 0xFF, 0xBA, 0x0A, 0xBF, 0x45, 0xFF, 0xFF, 0x54, 0xFB, 0xA0, 0xAB, 0xFF, 0xFF, 0xFF]
      - [0xEF, 0x10, 0x0D, 0x04, 0x08, 0x3F, 0x1F]
      - [0xFF, 0x77, 0x01, 0x00, 0x00, 0x13]
      - [0xEF, 0x08]
      - [0xFF, 0x77, 0x01, 0x00, 0x00, 0x00]
      - [0x36, 0x08]
      - [0x3A, 0x60]
      - [0x11]
      - delay 100ms
      - [0x29]
      - delay 50ms

# Palette, from the reference photo
substitutions:
  # reSpeaker voice satellite entity prefix (alarm + timers).
  voice_sat: respeaker_xvf3800_assistant
  # v3 light sensor (created on the reSpeaker by respeaker-light-sensor.yaml).
  lux_sensor: sensor.respeaker_xvf3800_assistant_ambient_light
  # Media player controlled from the control page (volume / mute).
  music_player: media_player.bedroom_speaker   # <- your HA media player
  c_dial: "0xFCEBEC"
  c_numeral: "0x6E0A1E"
  c_hour: "0xF08090"
  c_minute: "0xD8404F"
  c_second: "0x3BA7DC"

lvgl:
  displays:
    - my_display
  touchscreens:
    - touchscreen_id: touch_panel
  buffer_size: 50%
  # The panel sits in the enclosure with its native top edge pointing left.
  # Rotate the UI 90° clockwise so 12 is at the top. Software rotation in LVGL;
  # touch is remapped to match automatically.
  rotation: 90
  pages:
    - id: clock_page
      bg_color: ${c_dial}
      widgets:
        # Hour ticks where there is no numeral.
        - line:
            id: tick0
            align: TOP_LEFT
            points: ["339,69", "352,46"]
            line_width: 8
            line_color: ${c_numeral}
            line_rounded: true
        - line:
            id: tick1
            align: TOP_LEFT
            points: ["411,141", "434,128"]
            line_width: 8
            line_color: ${c_numeral}
            line_rounded: true
        - line:
            id: tick2
            align: TOP_LEFT
            points: ["411,339", "434,352"]
            line_width: 8
            line_color: ${c_numeral}
            line_rounded: true
        - line:
            id: tick3
            align: TOP_LEFT
            points: ["339,411", "352,434"]
            line_width: 8
            line_color: ${c_numeral}
            line_rounded: true
        - line:
            id: tick4
            align: TOP_LEFT
            points: ["141,411", "128,434"]
            line_width: 8
            line_color: ${c_numeral}
            line_rounded: true
        - line:
            id: tick5
            align: TOP_LEFT
            points: ["69,339", "46,352"]
            line_width: 8
            line_color: ${c_numeral}
            line_rounded: true
        - line:
            id: tick6
            align: TOP_LEFT
            points: ["69,141", "46,128"]
            line_width: 8
            line_color: ${c_numeral}
            line_rounded: true
        - line:
            id: tick7
            align: TOP_LEFT
            points: ["141,69", "128,46"]
            line_width: 8
            line_color: ${c_numeral}
            line_rounded: true
        - label:
            id: num12
            align: CENTER
            y: -150
            text_font: font_numerals
            text_color: ${c_numeral}
            text: "12"
        - label:
            id: num3
            align: CENTER
            x: 162
            text_font: font_numerals
            text_color: ${c_numeral}
            text: "3"
        - label:
            id: num6
            align: CENTER
            y: 156
            text_font: font_numerals
            text_color: ${c_numeral}
            text: "6"
        - label:
            id: num9
            align: CENTER
            x: -162
            text_font: font_numerals
            text_color: ${c_numeral}
            text: "9"
        # Timer ring at the very edge, and countdown text above the 6.
        - arc:
            id: timer_arc
            align: CENTER
            width: 476
            height: 476
            rotation: 270
            start_angle: 0
            end_angle: 360
            min_value: 0
            max_value: 1000
            value: 1000
            adjustable: false
            clickable: false
            hidden: true
            arc_opa: TRANSP
            indicator:
              arc_color: ${c_second}
              arc_width: 8
              arc_rounded: true
            knob:
              opa: TRANSP
        - label:
            id: lbl_timer
            align: CENTER
            y: 76
            text_font: font_name
            text_color: ${c_second}
            hidden: true
            text: ""
        - label:
            id: lbl_alarm
            align: CENTER
            y: -82
            text_font: montserrat_24
            text_color: 0x9A4A5A
            hidden: true
            text: ""
        # Mic muted: red mic-off icon inside the 9.
        - label:
            id: lbl_mute
            align: CENTER
            x: -98
            text_font: font_icons
            text_color: ${c_minute}
            hidden: true
            text: "\U000F036D"
        # Hands. Transparent meter laid over the dial; 0 is at 12 o'clock.
        - meter:
            id: clock_meter
            align: CENTER
            width: 480
            height: 480
            bg_opa: TRANSP
            border_width: 0
            pad_all: 0
            scrollable: false
            pivot:
              bg_color: ${c_minute}
              width: 26
              height: 26
            scales:
              - range_from: 0
                range_to: 720
                angle_range: 360
                rotation: 270
                indicators:
                  - line:
                      id: hour_hand
                      width: 22
                      color: ${c_hour}
                      length: 115
                      rounded: true
              - range_from: 0
                range_to: 3600
                angle_range: 360
                rotation: 270
                indicators:
                  - line:
                      id: minute_hand
                      width: 18
                      color: ${c_minute}
                      length: 180
                      rounded: true
        # Invisible layer on top: tap anywhere on the clock to open controls.
        - obj:
            align: CENTER
            width: 480
            height: 480
            bg_opa: TRANSP
            border_width: 0
            on_click:
              - script.execute: open_control

    - id: control_page
      bg_color: ${c_dial}
      widgets:
        - arc:
            id: arc_level
            align: CENTER
            width: 440
            height: 440
            start_angle: 135
            end_angle: 45
            min_value: 0
            max_value: 100
            value: 0
            adjustable: true
            arc_color: 0xF3D3D6
            arc_width: 26
            arc_rounded: true
            indicator:
              arc_color: ${c_minute}
              arc_width: 26
              arc_rounded: true
            knob:
              bg_color: ${c_numeral}
              pad_all: 6
            on_change:
              - lambda: |-
                  int i = id(dev_idx);
                  int v = (int) x;
                  if (i == vc::SCREEN_IDX && v < 5) v = 5;
                  id(levels)[i] = v;
                  id(last_local_ms)[i] = millis();
                  lv_label_set_text(id(lbl_value), (std::to_string(v) + "%").c_str());
              - script.execute: idle_timer
            on_release:
              - script.execute:
                  id: apply_level
                  idx: !lambda 'return id(dev_idx);'
                  level: !lambda 'return id(levels)[id(dev_idx)];'
        - label:
            id: lbl_name
            align: CENTER
            y: -100
            text_font: font_name
            text_color: ${c_numeral}
            text: ""
        - label:
            id: lbl_value
            align: CENTER
            y: -10
            text_font: font_value
            text_color: ${c_numeral}
            text: ""
        - label:
            id: lbl_status
            align: CENTER
            y: 68
            text_font: font_small
            text_color: 0x9A4A5A
            text: ""
        # Centre tap target (select / toggle).
        - obj:
            align: CENTER
            width: 220
            height: 200
            y: -20
            bg_opa: TRANSP
            border_width: 0
            on_click:
              - script.execute: center_tap
        - button:
            id: btn_prev
            align: CENTER
            x: -158
            width: 56
            height: 56
            radius: 28
            bg_color: 0xF3D3D6
            shadow_width: 0
            widgets:
              - label:
                  align: CENTER
                  text_font: montserrat_28
                  text_color: ${c_numeral}
                  text: "\uF053"
            on_click:
              - script.execute:
                  id: knob_step
                  dir: -1
        - button:
            id: btn_next
            align: CENTER
            x: 158
            width: 56
            height: 56
            radius: 28
            bg_color: 0xF3D3D6
            shadow_width: 0
            widgets:
              - label:
                  align: CENTER
                  text_font: montserrat_28
                  text_color: ${c_numeral}
                  text: "\uF054"
            on_click:
              - script.execute:
                  id: knob_step
                  dir: 1
        - obj:
            id: dot0
            align: CENTER
            x: -40
            y: 156
            width: 12
            height: 12
            radius: 6
            bg_color: 0xEBC2C7
            border_width: 0
            clickable: false
        - obj:
            id: dot1
            align: CENTER
            x: -20
            y: 156
            width: 12
            height: 12
            radius: 6
            bg_color: 0xEBC2C7
            border_width: 0
            clickable: false
        - obj:
            id: dot2
            align: CENTER
            x: 0
            y: 156
            width: 12
            height: 12
            radius: 6
            bg_color: 0xEBC2C7
            border_width: 0
            clickable: false
        - obj:
            id: dot3
            align: CENTER
            x: 20
            y: 156
            width: 12
            height: 12
            radius: 6
            bg_color: 0xEBC2C7
            border_width: 0
            clickable: false
        - obj:
            id: dot4
            align: CENTER
            x: 40
            y: 156
            width: 12
            height: 12
            radius: 6
            bg_color: 0xEBC2C7
            border_width: 0
            clickable: false
        - button:
            id: btn_home
            align: CENTER
            y: 196
            width: 64
            height: 44
            radius: 22
            bg_color: 0xF3D3D6
            shadow_width: 0
            widgets:
              - label:
                  align: CENTER
                  text_font: montserrat_28
                  text_color: ${c_numeral}
                  text: "\uF015"
            on_click:
              - script.execute: show_clock
