asherflynt/voice-clock/(commit log)

2026-11-01 Voice Clock v0: CAD, print files, firmware and assembly guide
    Open-source Home Assistant voice clock: CrowPanel 2.1" knob display,
    reSpeaker XVF3800 mic array and a 3 W speaker in a knit-textured 120 mm
    sphere.
    - cad/: parametric build123d model, fit checks, 3MF/STL export, Blender
    photoreal renders with automatic callouts
    - print/: Snapmaker U1 3MF (4 plates), single-plate 3MFs, STL and STEP
    - firmware/: ESPHome clock face for the CrowPanel
    - docs/: build plan, design notes, illustrated assembly guide
    [VoiceClock_U1.3mf, VoiceClock_plate1.3mf, VoiceClock_plate2.3mf, VoiceClock_plate3.3mf, VoiceClock_plate4.3mf, back_plate.step, back_plate.stl, board_spacers.step]
2026-11-01 Rotate the reSpeaker so its mute button sits under the plunger
    The mute button is the one marked A, at 9 o'clock seen from the LED side
    with the XIAO at the top (confirmed on hardware via the Home Assistant
    mic-mute switch). RS_ROT is now -90, which puts it at 12 o'clock.
    - Rear-shell ribs move to 0/150/270 deg so they clear the M2 clamp heads
    (41/180/319), the rim screws and the back-plate lug driver paths
    - Cable notch moves to the lower left seen from the front
    - Print files, renders and assembly guide regenerated
    [VoiceClock_U1.3mf, VoiceClock_plate1.3mf, VoiceClock_plate2.3mf, VoiceClock_plate3.3mf, VoiceClock_plate4.3mf, back_plate.step, board_spacers.step, board_spacers.stl]
2026-11-03 Fix 3MF plate placement and filament slots for Snapmaker Orca
    Meshes are now written centred on their own origin with placement in the
    build-item transforms (as slicer-saved 3MFs do), so parts load onto their
    plates. Filament slots match the U1 as loaded: 1 = PETG light guide,
    2 = matte PLA body, 4 = TPU washers.
    [VoiceClock_U1.3mf, VoiceClock_plate1.3mf, VoiceClock_plate2.3mf, VoiceClock_plate3.3mf, VoiceClock_plate4.3mf]
2026-11-03 Fix spider arms severed by the connector keep-out after the reSpeaker rotation
    Arms are now routed by measured clearance to the CrowPanel plug zones
    (straight, or one bend), and an arm that squeezes between two connectors
    is narrowed instead of being cut. The spider is one solid with full-width
    arms and no keep-out overlap.
    [VoiceClock_U1.3mf, VoiceClock_plate1.3mf, VoiceClock_plate2.3mf, VoiceClock_plate3.3mf, VoiceClock_plate4.3mf, spider.step, spider.stl]
2026-11-03 Regenerate guide renders with the fixed spider bracket
2026-11-03 Screw-mount for the measured 6-pin USB-C breakout
    The breakout (21.96 x 13.11 x 1.61, socket 3.30 tall overhanging the USB
    edge by 1.48, holes 18.95 outer-to-outer) stands on its USB edge with the
    socket through the back-plate slot, against a backing wall, located by end
    stops and held by 2x M2 x 10 threaded into oval holes. Replaces the
    glue-in cage. Adds a back-plate-only 3MF.
    [VoiceClock_U1.3mf, VoiceClock_back_plate_only.3mf, VoiceClock_plate1.3mf, VoiceClock_plate2.3mf, VoiceClock_plate3.3mf, VoiceClock_plate4.3mf, back_plate.step, back_plate.stl]
2026-11-04 Update insert tolerances to 3DZWMAN specs and pack PETG internals plate
    [VoiceClock_U1.3mf, VoiceClock_back_plate_only.3mf, VoiceClock_internals_PETG.3mf, VoiceClock_internals_with_back_plate_PETG.3mf, VoiceClock_plate1.3mf, VoiceClock_plate2.3mf, VoiceClock_plate3.3mf, VoiceClock_plate4.3mf]
2026-11-04 Fix XML syntax in model_settings.config and add universal generic 3MF exports
    [VoiceClock_U1.3mf, VoiceClock_back_plate_only.3mf, VoiceClock_internals_PETG.3mf, VoiceClock_internals_PETG_generic.3mf, VoiceClock_internals_with_back_plate_PETG.3mf, VoiceClock_internals_with_back_plate_PETG_generic.3mf, VoiceClock_plate1.3mf, VoiceClock_plate2.3mf]
2026-11-04 Pack all external parts on single plate and provide generic 3MFs
    [VoiceClock_U1.3mf, VoiceClock_back_plate_only.3mf, VoiceClock_back_plate_only_generic.3mf, VoiceClock_externals_PLA.3mf, VoiceClock_externals_PLA_generic.3mf, VoiceClock_internals_PETG.3mf, VoiceClock_internals_PETG_generic.3mf, VoiceClock_internals_with_back_plate_PETG.3mf]
2026-11-04 Add snap-fit barb and flexure slot to mute button plunger (Option 2)
    [VoiceClock_U1.3mf, VoiceClock_back_plate_only.3mf, VoiceClock_back_plate_only_generic.3mf, VoiceClock_externals_PLA.3mf, VoiceClock_externals_PLA_generic.3mf, VoiceClock_internals_PETG.3mf, VoiceClock_internals_PETG_generic.3mf, VoiceClock_internals_with_back_plate_PETG.3mf]
2026-11-05 v1: snap-fit shells, smaller sphere, wider base, mute plunger on BUTA
    - Sphere 120 -> 116 mm, flat base 42 -> 54 mm, 109 mm tall (was 116)
    - Split moved to 1 mm in front of the reSpeaker; board drops into rear-shell cradle ribs
    - Front/rear shell (4 hooks) and back plate (3 hooks, keyed) snap together; 9 M3 screws and inserts removed
    - Mute plunger moved to the rear shell on the measured BUTA nub (0.25 mm rest gap)
    - Knob gap 0.75 -> 0.45 mm; light guide centres on the CrowPanel housing
    - Cable notch 195 -> 120 deg (between LEDs, clear of the jack)
    - check.py tests against the vendor reSpeaker STEP plus assembly sweeps
    - New print plates, Blender renders, assembly guide and wiring sheets
    Co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
    [VoiceClock_U1.3mf, VoiceClock_back_plate_only.3mf, VoiceClock_back_plate_only_generic.3mf, VoiceClock_externals_PLA.3mf, VoiceClock_externals_PLA_generic.3mf, VoiceClock_internals_PETG.3mf, VoiceClock_internals_PETG_generic.3mf, VoiceClock_internals_with_back_plate_PETG.3mf]
2026-11-05 Add turned-cherry wood PLA variant for the Snapmaker U1
    - cad/wood.py: continuous 3D growth-ring grain across all shells, painted per
    triangle (cherry + walnut rings) with a faint open-pore relief on every
    exterior surface
    - cad/wood_temps.py: Orca post-processing script that drifts each head's
    temperature slowly so wood PLA shades naturally; leaves standby temps alone
    - cad/wood_project.py: JAYO wood presets, Snapmaker Orca project 3MF, CLI
    slicing (works around 2.4.1 CLI quirks) and post-processing
    - make_3mf.py: writes Orca paint_color per triangle
    - Blender wood materials + renders, print/wood README
    [VoiceClock_wood_U1.3mf, VoiceClock_wood_model.3mf]
2026-11-05 Wood variant: save project with back-plate support painting
    Supports are on (tree, manual), so only the painted area of the back plate
    is supported. Heads 1 and 2 use the JAYO cherry and walnut presets.
    [VoiceClock_wood_U1.3mf]
2026-11-05 Assembly step 1: show the back plate inserts clearly
    The old render looked at the back plate from outside, so its two speaker
    bosses and inserts were hidden and unlabelled. Step 1 now has two pictures:
    the spider from below, and the back plate's inside face with arrows into
    the bosses.
2026-11-06 Firmware: rotate the clock face to match the enclosure
    The enclosure mounts the CrowPanel with its native display top pointing
    left, so the face showed 12 at 9 o'clock.
    - lvgl rotation: 90 turns the UI a quarter turn (software; touch follows).
    - New "Face Trim" number (-10..10 deg, default 5, live from HA) turns the
    whole UI a few more degrees to cancel the stack's mounting play. Each
    page's widgets now sit in a transparent container that carries LVGL's
    transform_rotation.
    - Night mode hides the second hand instead of making it transparent, and
    the alarm label only redraws on change, to keep the trimmed face cheap.
    - READMEs: document the orientation fix; correct the CAD note that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
    [voice-clock.yaml]
2026-11-06 Firmware: show a mic-off icon on the clock face while muted
    Reads the reSpeaker's microphone mute switch from Home Assistant and shows
    a red Material Design mic-off icon inside the 9 (dimmed at night). The
    reSpeaker's own LED ring firmware may not show mute, and the light ring
    doesn't carry much light yet, so the screen is the reliable cue.
    [voice-clock.yaml]
2026-11-06 Firmware: drop the second hand and trim only the clock face
    With the Face Trim on, every second-hand tick re-rendered a large part of
    the face through LVGL's transform: frames took 150-600 ms, touch and the
    knob lagged, and one long render tripped the watchdog (which also rolled
    back an OTA update).
    - Remove the second hand; move the hands once a minute. Overlays (timer
    countdown, alarm, mute icon) still update every second.
    - Apply the trim to the clock face only; unwrap the control page so its
    buttons, arc and knob feedback render untransformed.
    Measured after the change: slow frames only at boot and on the minute
    (~200-260 ms), none in between.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
2026-11-06 Firmware: remove the Face Trim; level the dial in the enclosure instead
    Rotating the face by a few degrees in LVGL made every redraw slow
    (200-600 ms) and the knob and touch laggy. The small angle is now fixed
    mechanically (CP_ROT_TRIM_DEG in the CAD), so the firmware keeps only the
    free 90° rotation. The face stays without a second hand; hands move once
    a minute.
    [voice-clock.yaml]
2026-11-07 v2 enclosure: twist locks, keyed stack, foil light ring, ballast
    v1 printed but fell apart: the back plate clips rotated out, the front and
    rear shells popped apart, the carrier turned in the shell, the light guide
    barely lit, and the USB-C board had nothing to screw into.
    - Front/rear shells: 7-lug bayonet, 10 deg clockwise (seen from the front),
    4 flexure detent fingers, stop posts, flat bearing faces.
    - Back plate: 3-lug bayonet, 32 deg clockwise (seen from the back),
    2 flexure pawls, hard stop, coin slot.
    - Stack keyed: cradle ribs run down the wall into carrier notches.
    - Light ring: foil-tape-lined hollow channel (ring_base + ring_shell),
    diffuser cap 2.35 mm proud; front shell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
    [C1_JAYO_Wood_Cherry_U1.3mf, VoiceClock_U1.3mf, VoiceClock_back_plate_only.3mf, VoiceClock_back_plate_only_generic.3mf, VoiceClock_externals_PLA.3mf, VoiceClock_externals_PLA_generic.3mf, VoiceClock_internals_PETG.3mf, VoiceClock_internals_PETG_generic.3mf]
2026-11-07 Firmware: one knob click per step, and brighter night mode
    - rotary_encoder resolution 2: this encoder clicks twice per quadrature
    cycle, so resolution 1 needed two clicks for every step.
    - Turning the knob on the clock face now opens the control page and acts
    on the same click, instead of spending the first click opening it.
    - Night brightness defaults to 22% (was 12%, too dark).
2026-11-07 Firmware: grayscale night mode
    Night mode now draws the clock in greys on black (numerals, ticks, hands,
    centre dot, alarm/timer/mute overlays) instead of dim reds, so it stays
    readable at a low backlight. Night brightness default back to 12%.
2026-11-07 Firmware: grayscale control page at night
    Night mode now also greys the control page: the level arc track,
    indicator and knob, the prev/next/home buttons and their icons, and the
    device dots. The home button gets an id (btn_home) so the theme can reach
    it.
2026-11-07 Mic channels with pointed roofs; carrier and spider in PLA
    Mic channels: research into the acoustic path (XMOS, TDK AN-1003, a lossy
    duct model, array geometry) found the 90 deg turn is acoustically
    irrelevant (cross-mode cut-on about 100 kHz) and that length is what
    matters. Routing straight through the front would be 31.7 mm and put the
    tube resonance at about 2.6 kHz, in the speech band, so the 14 mm L stays.
    The L now prints without bridges in the face-up front shell: a 45 deg cone
    roof on the vertical leg (d2.1) and a 55 deg ridge on the radial leg,
    meeting the bore circle at its 45 deg point. Lossy-duct model: under
    0.1 dB change from 1 to 4 kHz.
    check.py: the 4 mic channels are open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
    [VoiceClock_U1.3mf, VoiceClock_back_plate_only.3mf, VoiceClock_back_plate_only_generic.3mf, VoiceClock_externals_PLA.3mf, VoiceClock_externals_PLA_generic.3mf, VoiceClock_internals_PETG.3mf, VoiceClock_internals_PETG_generic.3mf, VoiceClock_internals_PLA.3mf]
2026-11-07 Firmware: restore night brightness default 12 (undo merge regression)
    The v2-enclosure merge brought back 22 from a cherry-picked copy of
    e5671e9; d7f668c had deliberately lowered it to 12.
2026-11-07 USB-C board: screws go in from the rim, where a short hex key reaches
    The breakout's 2 M2 screws went in from the socket side, toward the
    speaker, and were hard to reach. Now the board's socket side bears on two
    pads (one each side of the socket; contact only on 5 mm bosses round the
    holes) and the screws go in from the board's back, the plate's rim side.
    The bayonet spigot already has a gap there, so a hex key and the screws
    come straight in over the plate from its edge. Inserts are pressed into
    the pads' speaker-side face (through holes, so the screw pulls them
    deeper). The board moves 2 mm toward the edge (USB_CY -22 -> -24) so the
    M2x10 tips stop 1.76 mm short of the speaker. The board c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
    [VoiceClock_U1.3mf, VoiceClock_back_plate_only.3mf, VoiceClock_back_plate_only_generic.3mf, VoiceClock_externals_PLA.3mf, VoiceClock_externals_PLA_generic.3mf, VoiceClock_internals_PLA.3mf, VoiceClock_internals_PLA_generic.3mf, VoiceClock_internals_with_back_plate_PLA.3mf]
2026-11-07 Turned-walnut variant with Full Spectrum layer mixing (8 tones, no cherry)
    Modelled on a photo of a real turned bowl (research: tone percentiles,
    streak and ripple scales, heartwood zones). Snapmaker Orca 2.4.1 Full
    Spectrum turns the U1's 4 heads (plain brown PLA core, JAYO oak, JAYO
    maple in place of cherry, JAYO walnut) into 8 tones: each mixed tone is
    an exact per-layer head sequence ('mixed_filament_definitions' pattern
    rows, ids 5-10), painted per face like a 5th-10th head.
    wood.py 'walnut_fs': fine rippled growth rings far from the pith (side
    grain gives streaks, end grain gives ripples), lighter earlywood, latewood
    lines whose depth fades along the grain, darker end grain, soft grad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
    [FS_swatch_004.3mf, FS_swatch_008.3mf, VoiceClock_walnut_fs_004_U1.3mf, VoiceClock_walnut_fs_008_U1.3mf, VoiceClock_walnut_fs_model.3mf]
2026-11-09 No cable notch: CrowPanel fed from the reSpeaker; ring prints without brim
    The CrowPanel's power lead now starts at the reSpeaker header's spare 5V/GND
    pins on the LED side, inside the light ring, so nothing runs round the board
    edge. The chain is USB-C inlet -> disconnect -> reSpeaker header -> CrowPanel.
    - ring_base, ring_shell: cable notch removed; printed with no brim (it
    could not be peeled off the thin PETG walls)
    - carrier: edge notch removed; the centre hole is the only wire opening
    - rear shell: collar gap at 120 deg filled
    - check.py: cable-lane checks dropped (90 checks pass)
    - wiring sheets 01-05, WIRING.md, PDF and the assembly guide redrawn for
    the new route (no Y splice,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
    [FS_swatch_004.3mf, VoiceClock_U1.3mf, VoiceClock_externals_PLA.3mf, VoiceClock_externals_PLA_generic.3mf, VoiceClock_internals_PLA.3mf, VoiceClock_internals_PLA_generic.3mf, VoiceClock_internals_with_back_plate_PLA.3mf, VoiceClock_internals_with_back_plate_PLA_generic.3mf]
2026-11-09 Back plate: one-layer knit patch in the bed face so it isn't glossy
    The back plate prints outer face down, so its whole visible face was a smooth,
    shiny first layer. texture.bed_texture() carves the shells' knit stitch into
    it 0.22 mm deep: the stitches touch the bed (glossy), the grooves are bridged
    by the second layer (matte). 0.22 mm removes exactly one first layer at 0.2 or
    0.25 mm and keeps the wood variants' next 0.08 mm layer solid. A 2.5 mm rim,
    a 0.5 mm land round every hole and the two flexing pawl arms stay full
    thickness. Applied to the plain plates and to both wood variants.
    [VoiceClock_U1.3mf, VoiceClock_back_plate_only.3mf, VoiceClock_back_plate_only_generic.3mf, VoiceClock_externals_PLA.3mf, VoiceClock_externals_PLA_generic.3mf, VoiceClock_internals_with_back_plate_PLA.3mf, VoiceClock_internals_with_back_plate_PLA_generic.3mf, VoiceClock_plate1.3mf]
2026-11-09 Back plate texture on the walnut Full Spectrum variant only
    The one-layer knit patch in the back plate's bed face was meant for the walnut
    print only. The plain PLA plates and the cherry wood variant go back to a plain
    back plate (identical to 4dea9bc); wood.py applies bed_texture() for walnut_fs.
    [VoiceClock_U1.3mf, VoiceClock_back_plate_only.3mf, VoiceClock_back_plate_only_generic.3mf, VoiceClock_externals_PLA.3mf, VoiceClock_externals_PLA_generic.3mf, VoiceClock_internals_with_back_plate_PLA.3mf, VoiceClock_internals_with_back_plate_PLA_generic.3mf, VoiceClock_plate1.3mf]
2026-11-09 Walnut back plate: grain-line grooves instead of the knit stitch
    The knit pattern didn't belong on the wood look. The walnut variant's back
    plate now has its latewood lines grooved one layer (0.22 mm) deep, from the
    same grain field that paints them: the golden land touches the bed (glossy),
    the grain lines are bridged by the second layer (matte, in walnut).
    [VoiceClock_walnut_fs_008_U1.3mf, VoiceClock_walnut_fs_model.3mf]
2026-11-09 Walnut back plate: 8-tone dither and all-over stipple to match the shell
    The flat back plate prints on the bed, where one layer can't show a Z mix, so
    it only had 3 solid colours and looked blotchy next to the sphere. Its bed
    face now error-diffuses the same 8-tone grain onto walnut / core / oak / maple
    in 0.8 mm cells, and the grain-line grooves are replaced by an even stipple of
    random 1.2 mm dimples one layer deep (about 40 % of the face), so it reads
    satin like the shell instead of glossy.
    [VoiceClock_walnut_fs_008_U1.3mf, VoiceClock_walnut_fs_model.3mf]
2026-11-10 Light ring: cap overlaps the inner wall, no capacitor notches
    The diffuser cap now spans the whole ring and covers the inner wall's
    top (shiplap with a short skirt and crush ribs), so there is no gap at
    the face and no straight view down to the LEDs. The inner wall's foot
    moves inside the LED capacitors, so the 12 notches are gone; the LEDs
    still sit between the two walls.
    [VoiceClock_U1.3mf, VoiceClock_light_ring_PETG.3mf, VoiceClock_light_ring_PETG_generic.3mf, VoiceClock_plate3.3mf, VoiceClock_v2_fit_plate3.3mf, VoiceClock_v2_fit_tests.3mf, assembly_D.step, ring_base.step]
2026-11-10 Back plate: speaker 6 mm toward the top for the USB-C board's plug
    The USB-C board's JST plug and lead had about 10 mm between the board
    and the speaker. The speaker (grille, bosses) now sits 6 mm up, giving
    16 mm; the lead anchor stays inside the spigot ring. New check: board
    face to speaker >= 14 mm. Plain, cherry and walnut prints regenerated.
    [VoiceClock_U1.3mf, VoiceClock_back_plate_only.3mf, VoiceClock_back_plate_only_generic.3mf, VoiceClock_externals_PLA.3mf, VoiceClock_externals_PLA_generic.3mf, VoiceClock_internals_with_back_plate_PLA.3mf, VoiceClock_internals_with_back_plate_PLA_generic.3mf, VoiceClock_plate1.3mf]
2026-11-11 Light ring: white PETG channel walls, no foil tape
    Foil tape was too fiddly to apply and ate the tolerances. The channel
    walls now print in white PETG (slot 2 on the light-ring plate), which
    reflects the LED light; only the ring shell's cap and the band above
    the case print in natural PETG (slot 1), in the same print, as one
    two-part object. make_3mf.py writes multi-part objects; slice_ring.py
    slices the plate for the U1 (no brim, no skirt). Docs drop the foil
    steps.
    [LightRing_PETG_U1.3mf, LightRing_PETG_model.3mf, VoiceClock_U1.3mf, VoiceClock_light_ring_PETG.3mf, VoiceClock_plate3.3mf, ring_shell_natural.stl, ring_shell_white.stl]
2026-11-11 Assembly guide: re-render without foil tape, white PETG ring
    The step 4 and step 7 pictures still showed foil tape with "Foil tape"
    callouts. The render scene drops the foil meshes, the ring base and the
    ring shell's sleeve render as white PETG with the natural band on top,
    and all assembly images are re-rendered (they also pick up the
    overlapping cap and the moved speaker).
2026-11-11 Light ring: retaining collar under the front shell, 0.3 mm bore gap
    The ring_shell slid out of the front if the clock was tipped, and the 0.6 mm gap
    to the front shell's bore looked loose. Only the ring_shell changes (the front
    shell is untouched): the sleeve is 0.3 mm thicker outward (0.3 mm gap), and a
    collar on the sleeve sits 0.3 mm under the front shell's inner wall, so the
    twisted-on front shell captures it. Four notches let the mic-boot lugs pass
    at the front shell's entry angle. check.py: PASS, with a new capture check.
    slice_ring.py also writes a shell-only plate and targets the engineering
    plate at 70 C.
    [LightRingShell_PETG_U1.3mf, LightRingShell_PETG_model.3mf, LightRing_PETG_U1.3mf, LightRing_PETG_model.3mf, VoiceClock_U1.3mf, VoiceClock_back_plate_only.3mf, VoiceClock_back_plate_only_generic.3mf, VoiceClock_externals_PLA.3mf]
2026-11-12 Bambu Lab projects (X1C, P1S, A1, A1 mini) and re-rendered assembly guide
    print/bambu: Bambu Studio projects with stock presets, built by cad/make_bambu.py
    through the Bambu Studio CLI and sliced to check every plate. Slots: PLA,
    translucent PETG, white PETG, TPU. The A1 mini gets 6 plates on its 180 mm bed.
    docs/assembly/img: every scene re-rendered from the current CAD (white PETG
    light ring with the new retaining collar). The previous no-foil update had only
    redrawn the labels: Blender never ran (relative script path inside the flatpak).
    [VoiceClock_A1.3mf, VoiceClock_A1mini.3mf, VoiceClock_P1S.3mf, VoiceClock_X1C.3mf]
2026-11-12 U1 TPU plate: grip pads + speaker washers on head 4
    print/tpu: standalone Snapmaker U1 project and model 3MF for the TPU parts,
    built by cad/slice_tpu.py (Snapmaker TPU 95A HF, 230 C, engineering plate at 30 C,
    3 mm brim on the washers only).
    [TPU_U1.3mf, TPU_model.3mf]
2026-11-12 Spider: CP_ROT_TRIM_DEG -5.0 -> -2.8
    A level photo of the v2 build shows the dial 2.2 deg clockwise (fit of all
    12 dial marks), so the -5 deg trim from the v1 photo overshot. Regenerated
    the spider STL/STEP, U1 plates and Bambu projects.
    [VoiceClock_A1.3mf, VoiceClock_A1mini.3mf, VoiceClock_P1S.3mf, VoiceClock_U1.3mf, VoiceClock_X1C.3mf, VoiceClock_back_plate_only.3mf, VoiceClock_back_plate_only_generic.3mf, VoiceClock_externals_PLA.3mf]
2026-11-12 README: photo and demo of the printed v2 (walnut)
2026-11-12 slice_spider.py: spider-only U1 plate (PLA Matte, one head)
2026-11-13 v3: ambient light sensor (Adafruit #5378 right-angle VEML7700)
    - Rear shell: flat pad with 2 M2 inserts at 12 o'clock behind the carrier, a
    d2.4 window (teardrop roof, flared to d5) looking 15 deg behind vertical,
    and a light shroud closing the gap to the curved wall. Prints without supports.
    - Carrier: 5 mm lead notch in the rim at 60 deg.
    - Sensor wired to the XIAO's I2C (D4/D5, 3V3, GND) with a STEMMA QT lead; the
    CrowPanel's ports sit inside the light ring, out of reach.
    - Firmware: respeaker-light-sensor.yaml package for the reSpeaker; the clock
    enters night mode below "Night Light Level" (3 lx, hysteresis x2) and falls
    back to sun + lamps when there is no reading.
    - check.py: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
    [VoiceClock_A1.3mf, VoiceClock_A1mini.3mf, VoiceClock_P1S.3mf, VoiceClock_U1.3mf, VoiceClock_X1C.3mf, VoiceClock_externals_PLA.3mf, VoiceClock_externals_PLA_generic.3mf, VoiceClock_internals_PLA.3mf]
2026-11-13 Make the light sensor an optional, untested variant (v2 stays the default)
    - voice_clock.py: the sensor pad, window, shroud and carrier notch are off by
    default (LIGHT_SENSOR, set with VC_LIGHT_SENSOR=1); the default build is
    byte-for-byte the printed v2 (rear shell 42027.3 mm3 textured, as before).
    - check.py: the sensor section runs only with the flag; PASS both ways.
    - print/: standard files restored to v2. The variant's rear shell, carrier and
    U1 / wood / walnut projects are in print/v3_light_sensor with a README that
    explains the design and what has and hasn't been checked.
    - Docs: the sensor is marked optional and untested everywhere (README, CAD
    README, build plan, assembly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
    [VoiceClock_A1.3mf, VoiceClock_A1mini.3mf, VoiceClock_P1S.3mf, VoiceClock_U1.3mf, VoiceClock_U1_light_sensor.3mf, VoiceClock_X1C.3mf, VoiceClock_externals_PLA.3mf, VoiceClock_externals_PLA_generic.3mf]
